z2labs/coaxolotl/simu/out/bank_generic.png

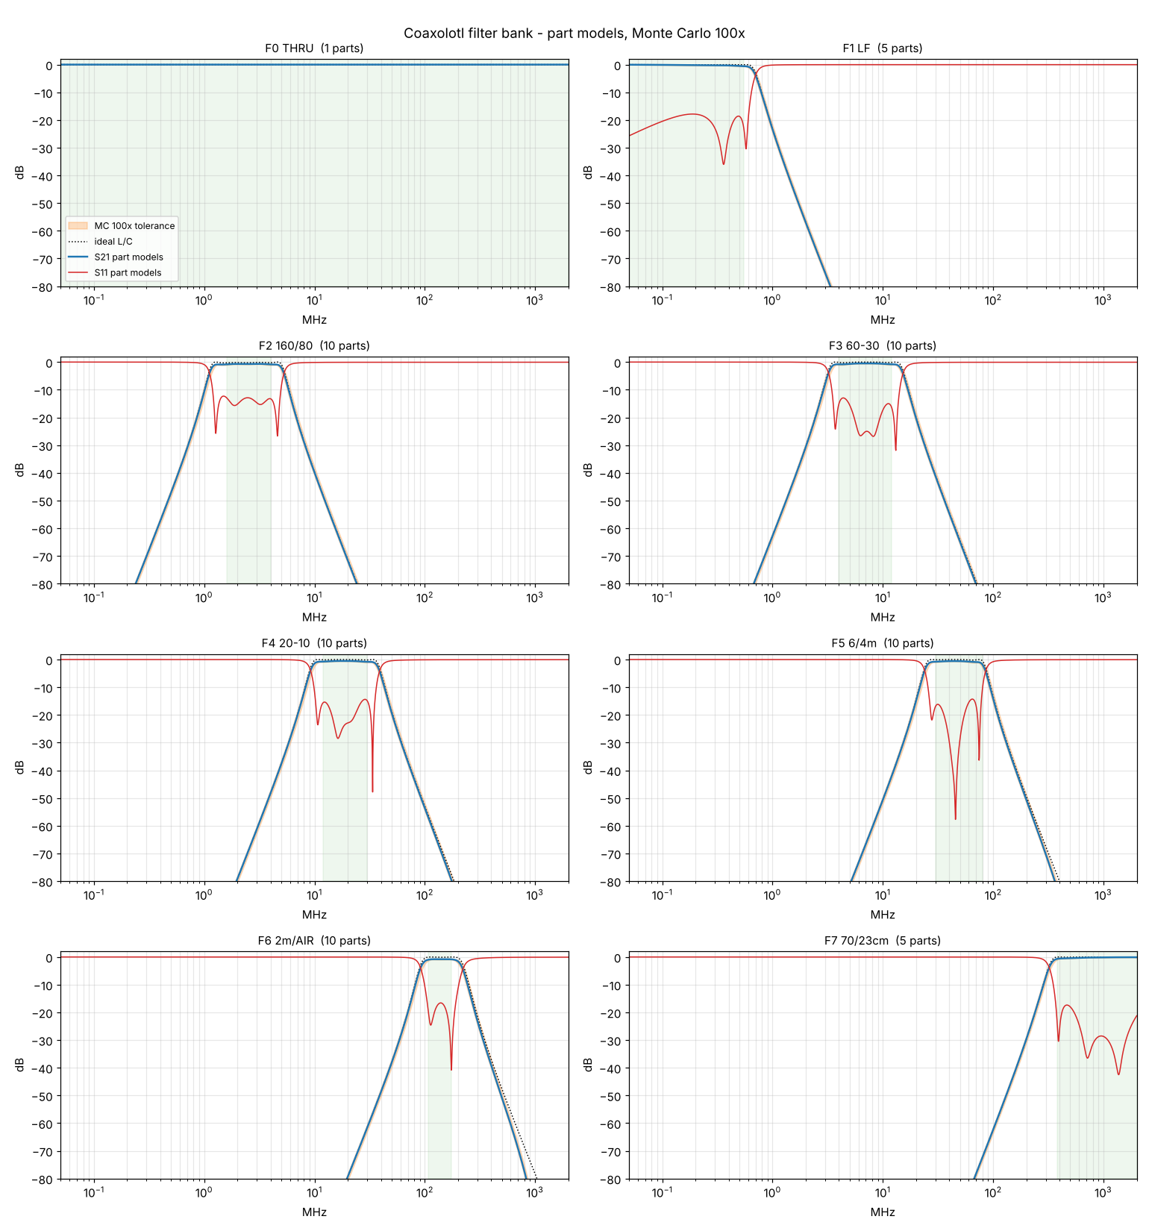
simu/out/bank_generic.png
