z2labs/coaxolotl/simu/out/bank_ideal.png

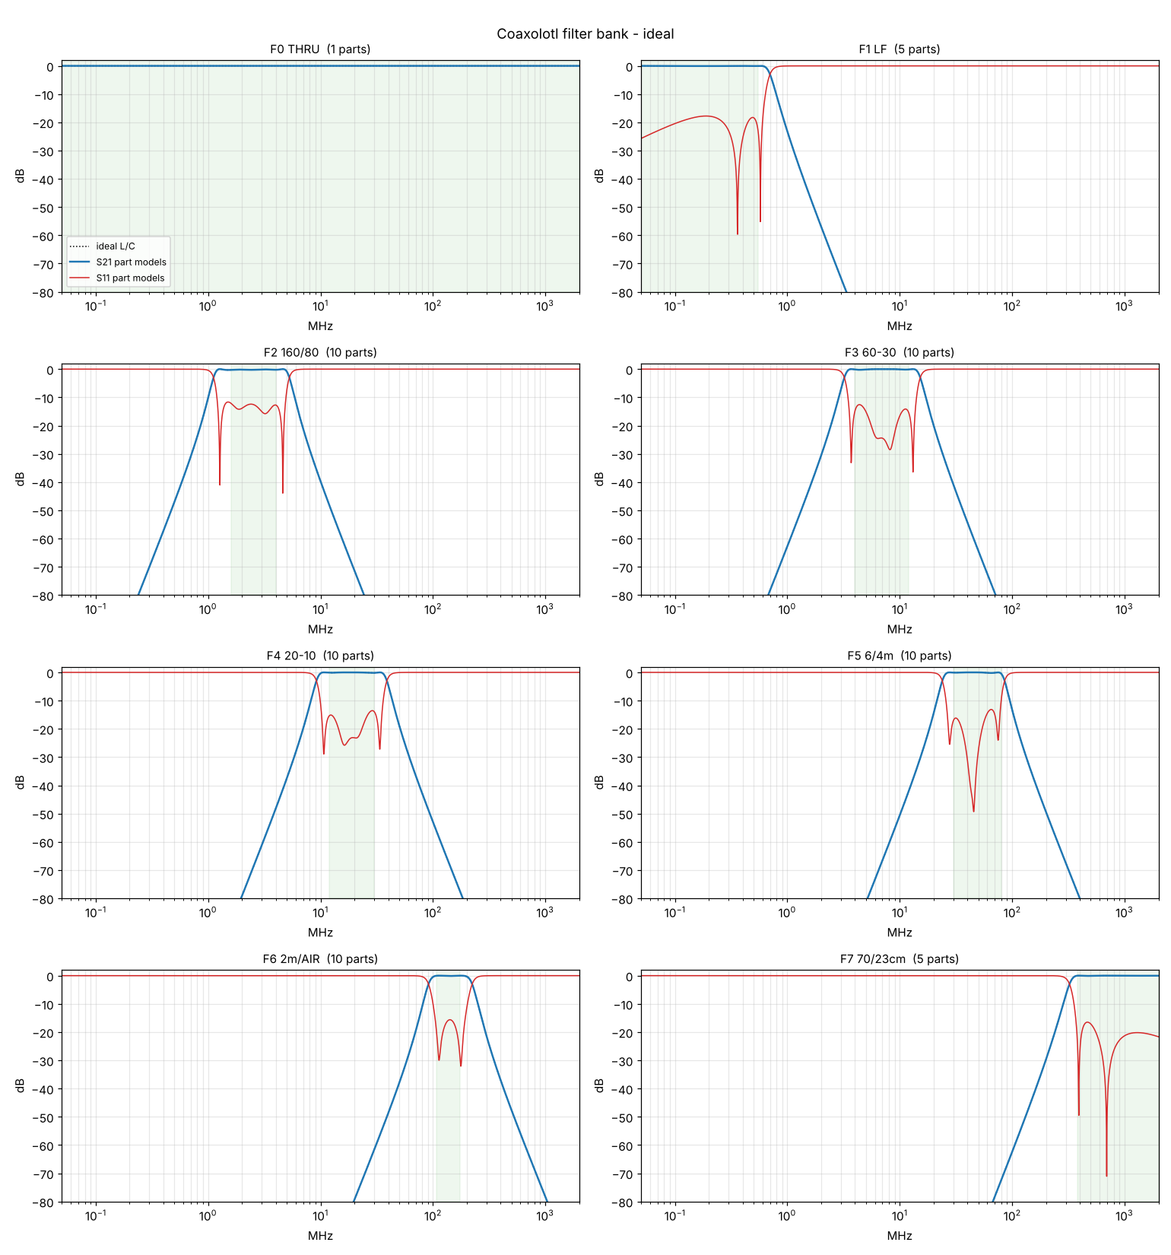
simu/out/bank_ideal.png
