z2labs/coaxolotl/simu/out/bank_models.png

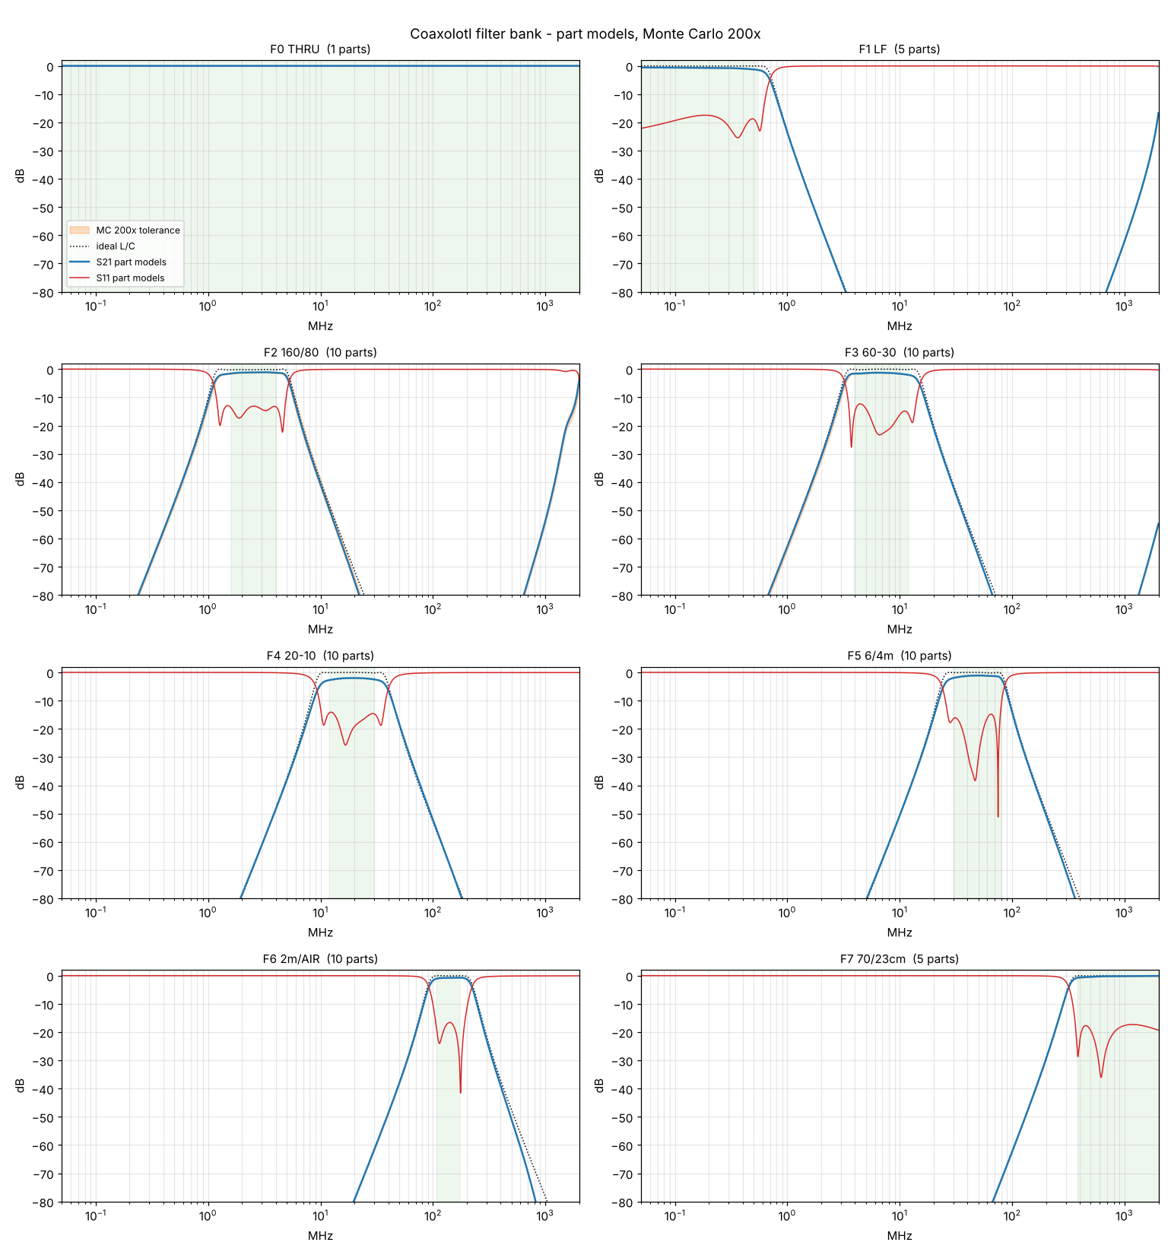
simu/out/bank_models.png
