z2labs/coaxolotl/simu/out/f0_layout.png

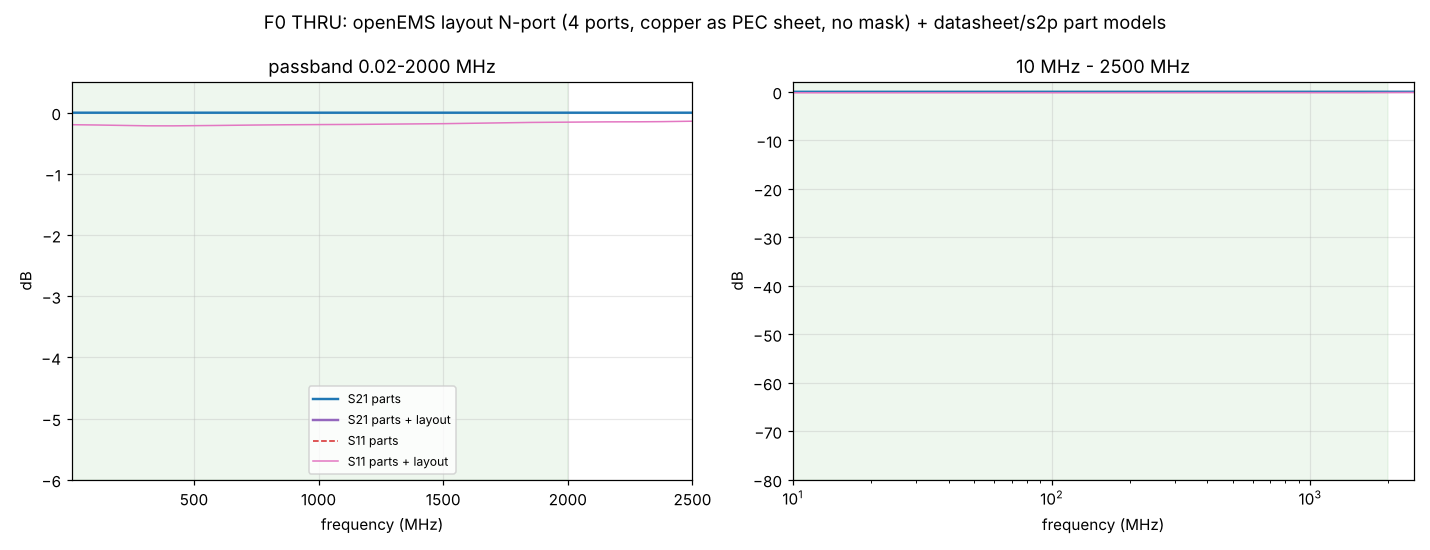
simu/out/f0_layout.png
