z2labs/coaxolotl/simu/out/f5_layout.png

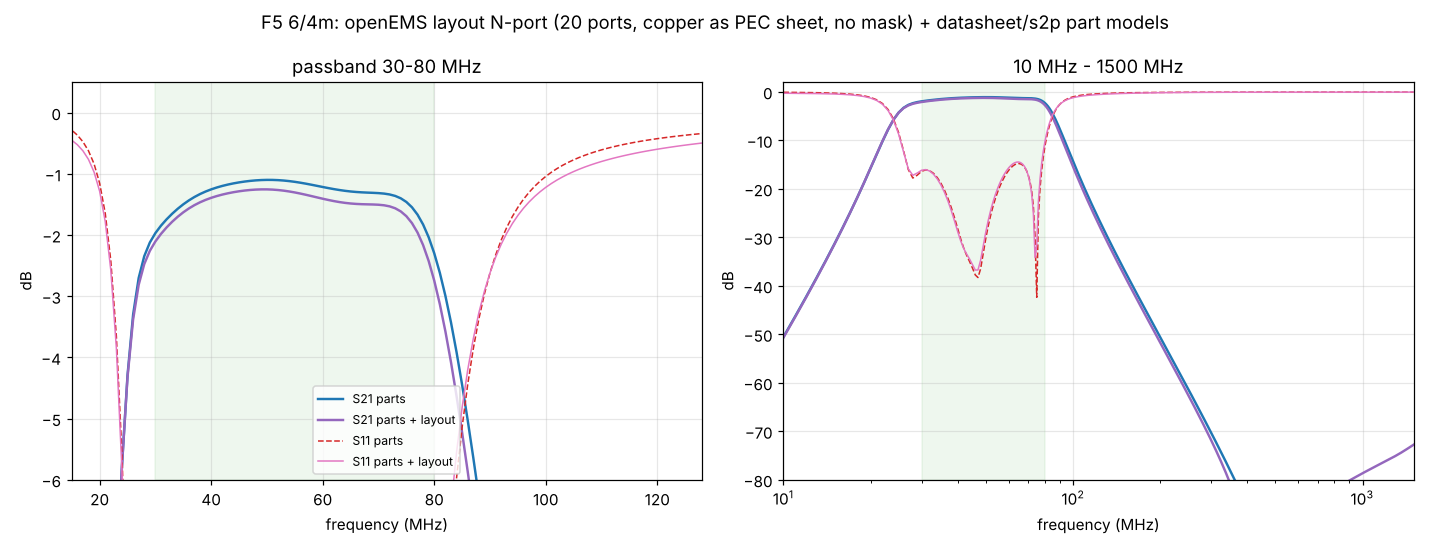
simu/out/f5_layout.png
