z2labs/coaxolotl/simu/out/f6_layout.png

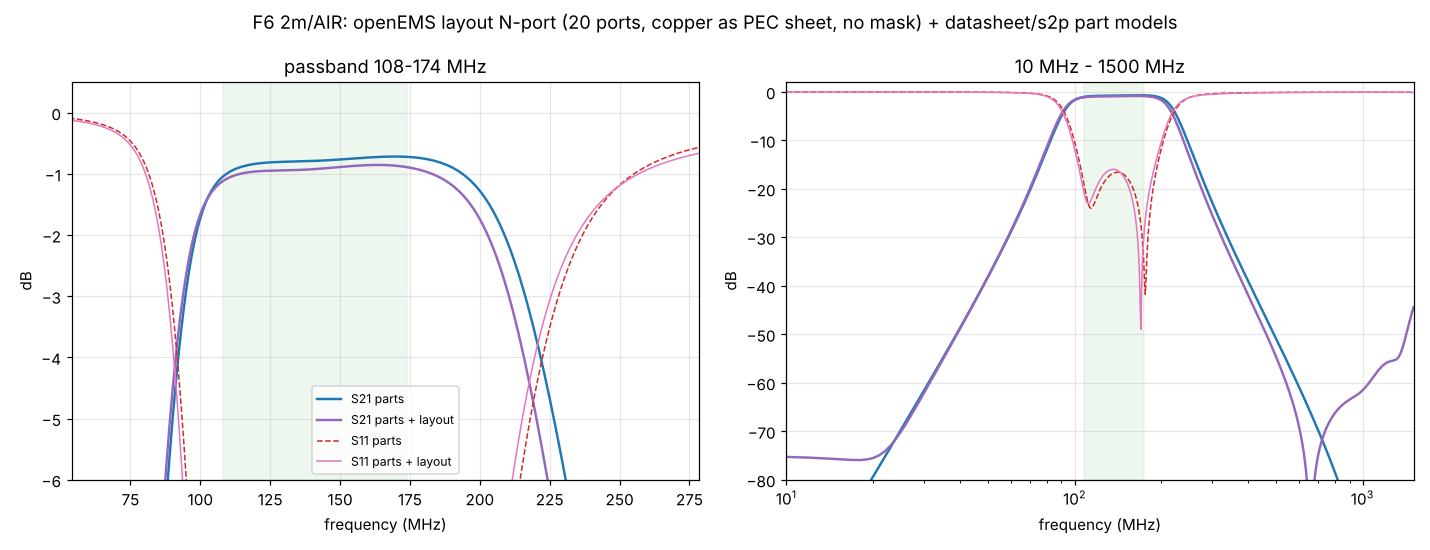
simu/out/f6_layout.png
