z2labs/coaxolotl/simu/out/f7_layout.png

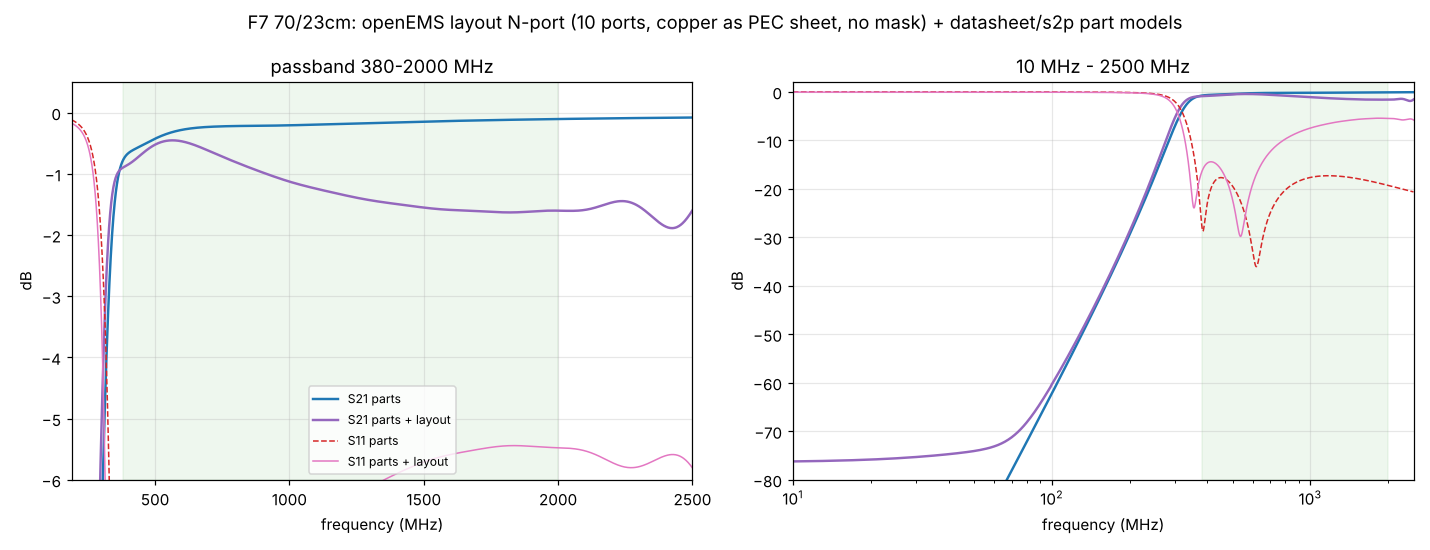
simu/out/f7_layout.png
