z2labs/coaxolotl/simu/out/f7_retune.png

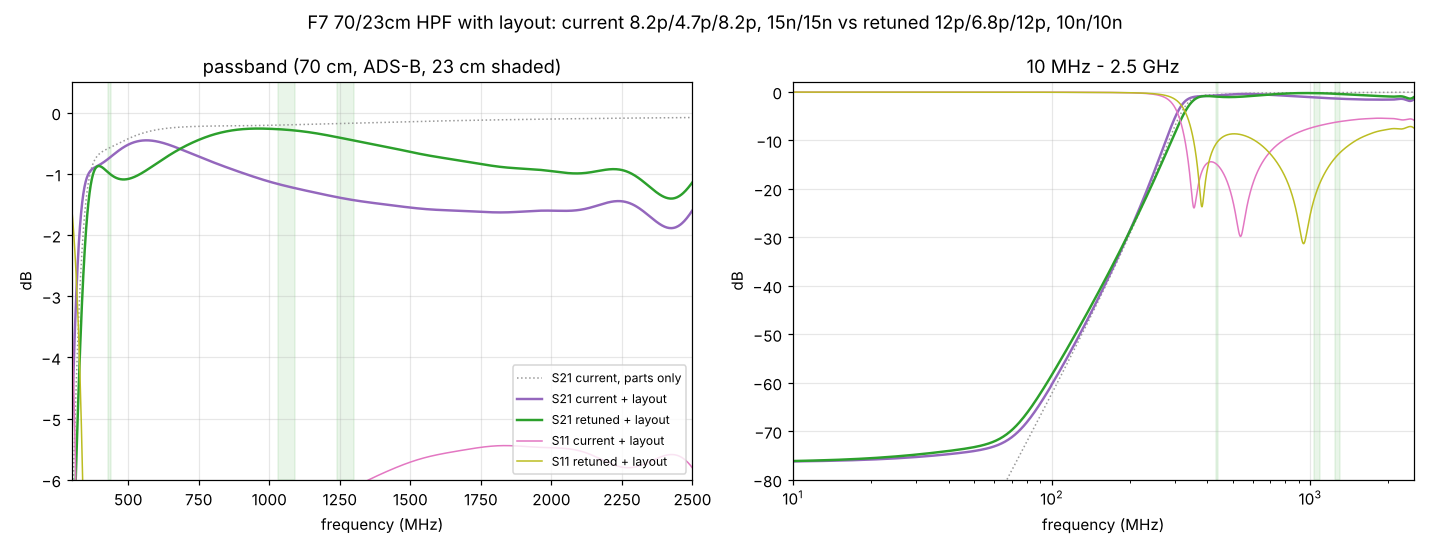
simu/out/f7_retune.png
