z2labs/coaxolotl/simu/out/f7void_layout.png

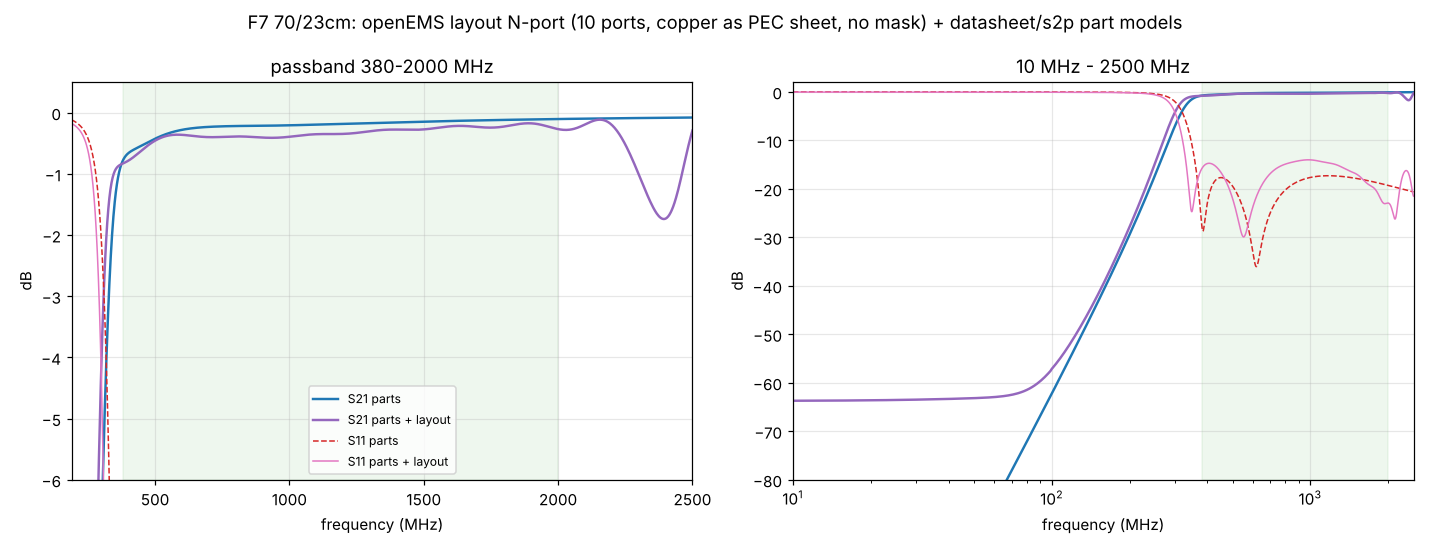
simu/out/f7void_layout.png
