z2labs/coaxolotl/simu/out/report_fig/bank.png

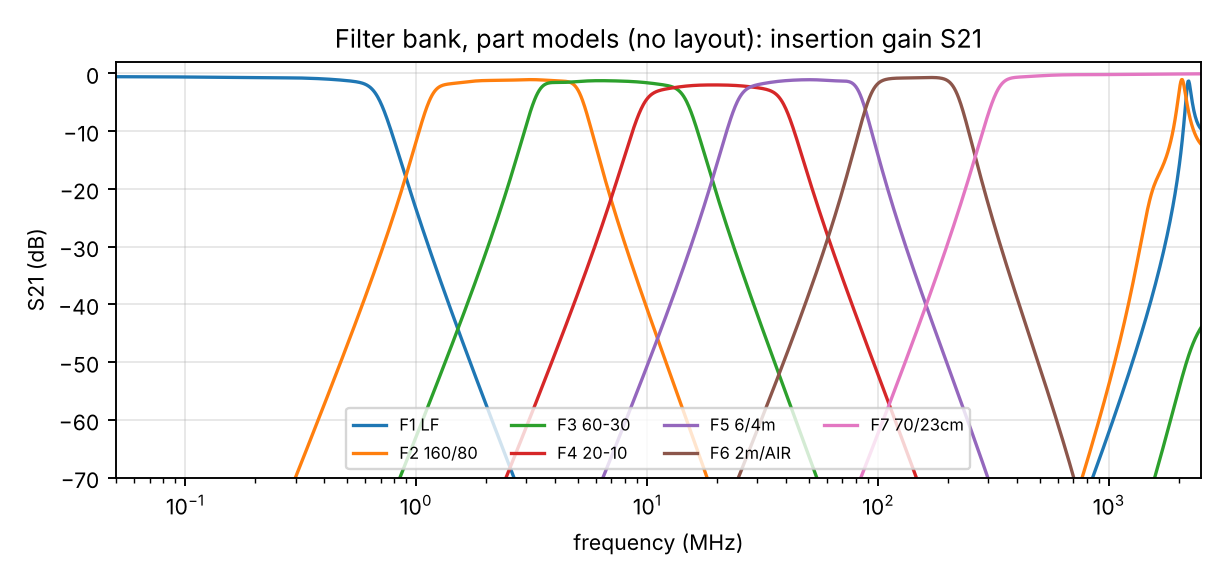
simu/out/report_fig/bank.png
