z2labs/coaxolotl/simu/out/report_fig/f7.png

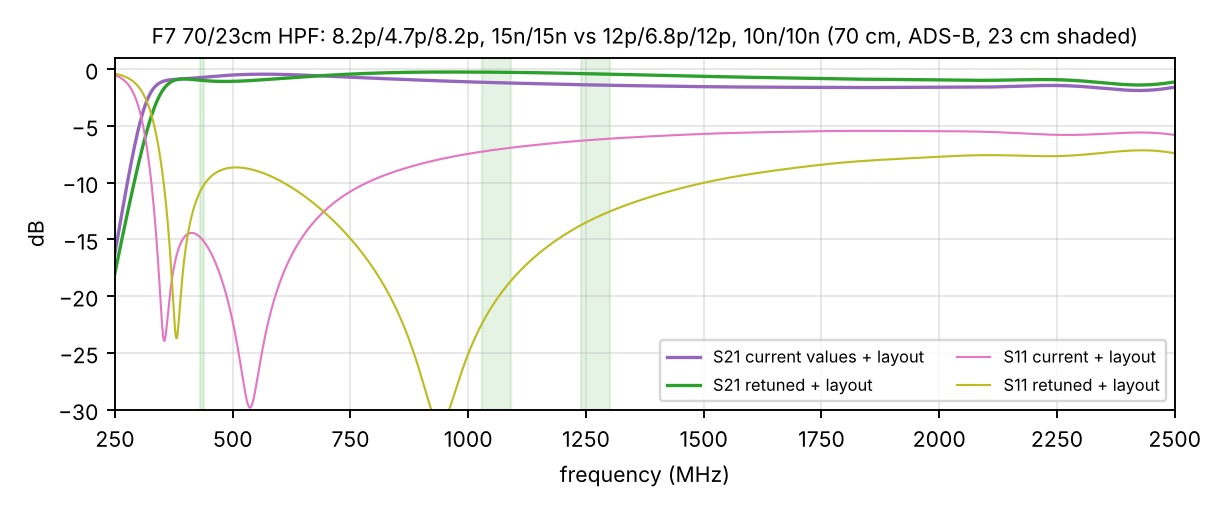
simu/out/report_fig/f7.png
