z2labs/coaxolotl/simu/out/report_fig/lanes.png

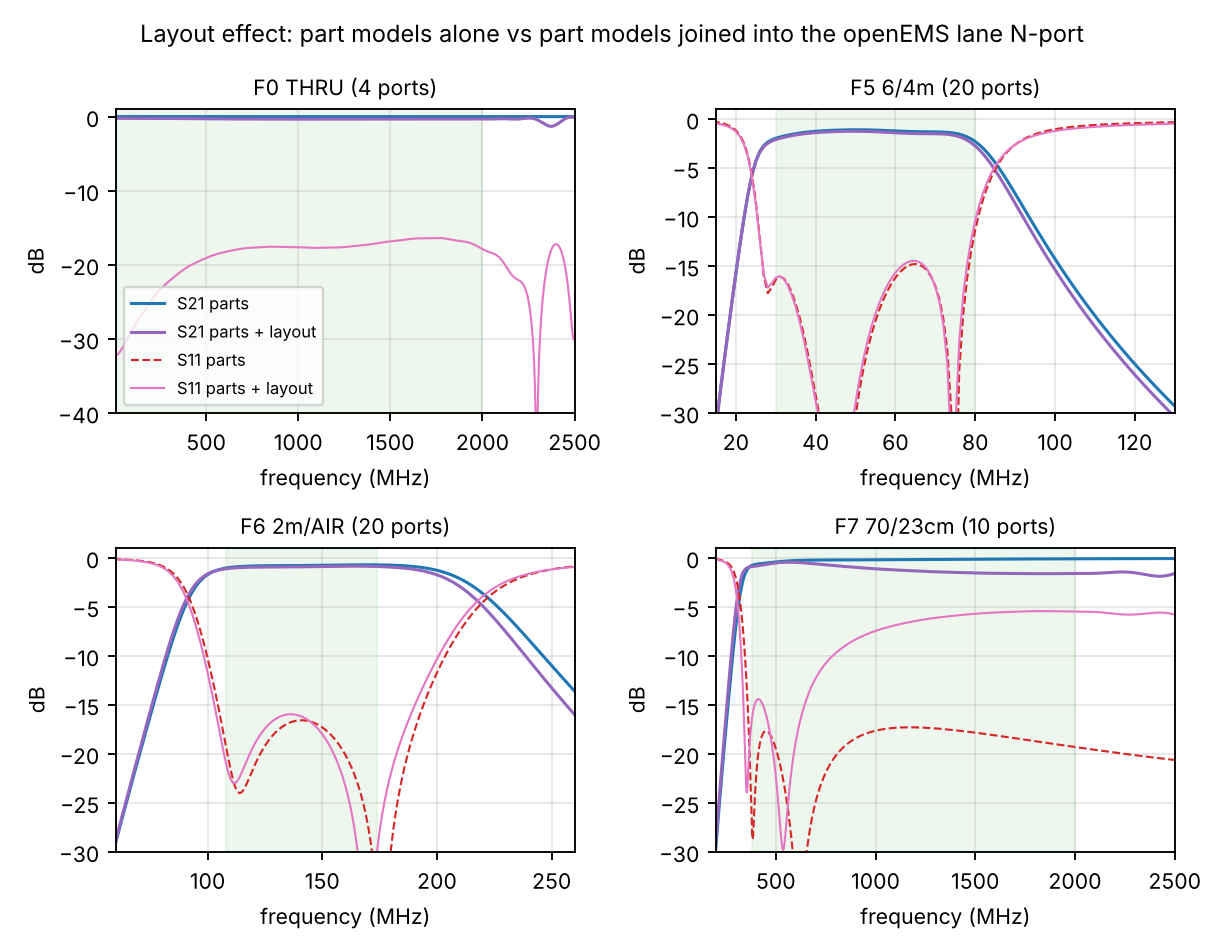
simu/out/report_fig/lanes.png
