z2labs/coaxolotl/simu/out/thru_layout.png

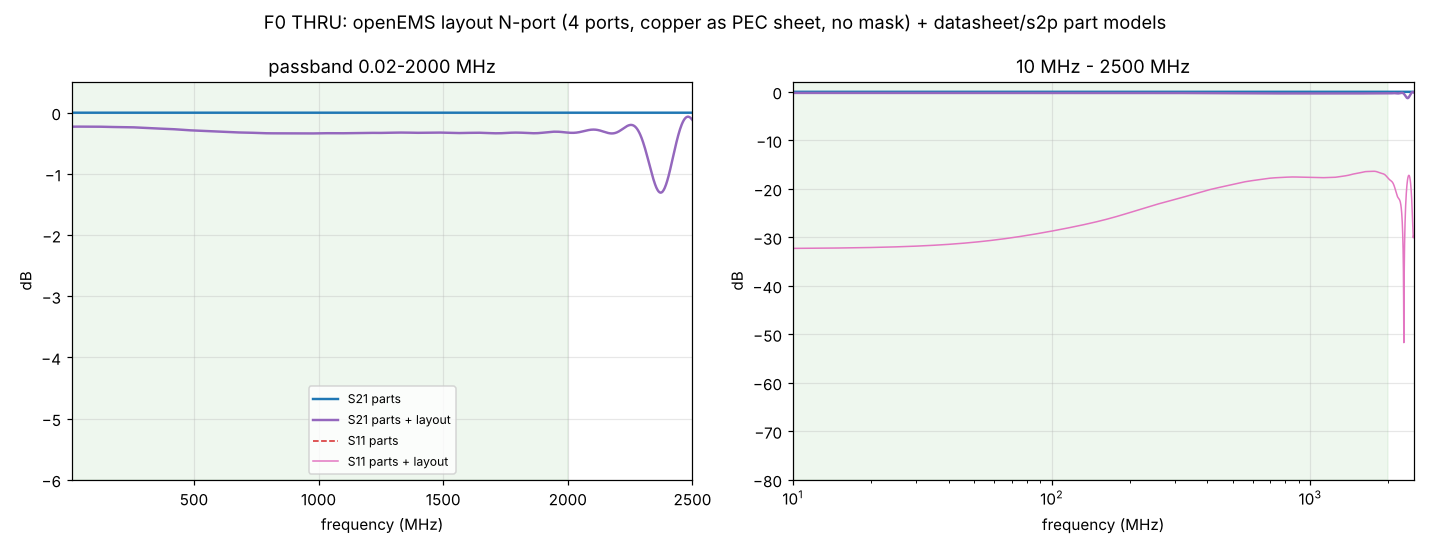
simu/out/thru_layout.png
