z2labs/coaxolotl/hardware/bom.csv

refs | qty | value | footprint | mpn | dnp | sheet | note
C1 C6 C7 C11 C15 C36 C37 C38 C39 C41 C42 C43 C44 C45 C46 | 15 | 100nF/16V/10% | C_0603_1608Metric |  |  | Filter bank, MCU, Panel, Power, RF front end
C2 | 1 | 10nF/50V/10% | C_0603_1608Metric |  |  | MCU
C3 | 1 | 10uF/10V/20% | C_0805_2012Metric |  |  | Power
C4 C5 C12 C13 C14 | 5 | 1uF/16V/10% | C_0603_1608Metric |  |  | MCU, Power
C8 | 1 | 47uF/10V/20% | C_1206_3216Metric |  |  | Power
C9 | 1 | 330uF/6.3V/20% | CP_EIA-7343-31_Kemet-D | T520D337M006ATE025 |  | Power
C10 | 1 | 0.1F/5.5V | CP_Radial_D13.0mm_P5.00mm | KR-5R5V104-R |  | Power | C10: VERIFY footprint vs chosen coin supercap
C24 C26 | 2 | 200pF/50V/C0G | C_0603_1608Metric |  |  | RF front end
C25 | 1 | 68pF/50V/C0G | C_0603_1608Metric |  |  | RF front end
C27 | 1 | NA(47pF/C0G) | C_0603_1608Metric |  | DNP | RF front end
C28 C31 C34 | 3 | 1nF/50V/C0G | C_0603_1608Metric |  |  | Filter bank, RF front end
C30 C32 C40 | 3 | 100pF/C0G | C_0603_1608Metric |  |  | RF front end
C33 | 1 | 2.2uF/16V/X7R | C_0805_2012Metric |  |  | Filter bank
C35 | 1 | 22pF/50V/C0G | C_0603_1608Metric |  |  | Filter bank
C101 C103 | 2 | 5.6nF/50V/C0G | C_0603_1608Metric |  |  | Filter bank
C102 | 1 | 10nF/50V/C0G | C_0603_1608Metric |  |  | Filter bank
C201 C203 | 2 | 2.2nF/50V/C0G | C_0603_1608Metric |  |  | Filter bank
C202 | 1 | 1.2nF/50V/C0G | C_0603_1608Metric |  |  | Filter bank
C204 C206 C301 C303 | 4 | 820pF/50V/C0G | C_0603_1608Metric |  |  | Filter bank
C205 | 1 | 1.5nF/50V/C0G | C_0603_1608Metric |  |  | Filter bank
C302 C305 | 2 | 470pF/50V/C0G | C_0603_1608Metric |  |  | Filter bank
C304 C306 C401 C403 | 4 | 270pF/50V/C0G | C_0603_1608Metric |  |  | Filter bank
C402 | 1 | 150pF/50V/C0G | C_0603_1608Metric |  |  | Filter bank
C404 C406 C501 C503 | 4 | 100pF/50V/C0G | C_0603_1608Metric |  |  | Filter bank
C405 | 1 | 180pF/50V/C0G | C_0603_1608Metric |  |  | Filter bank
C502 | 1 | 56pF/50V/C0G | C_0603_1608Metric |  |  | Filter bank
C504 C506 | 2 | 47pF/50V/C0G | C_0603_1608Metric |  |  | Filter bank
C505 | 1 | 82pF/50V/C0G | C_0603_1608Metric |  |  | Filter bank
C601 C603 | 2 | 27pF/50V/C0G | C_0603_1608Metric |  |  | Filter bank
C602 | 1 | 15pF/50V/C0G | C_0603_1608Metric |  |  | Filter bank
C604 C606 | 2 | 18pF/50V/C0G | C_0603_1608Metric |  |  | Filter bank
C605 | 1 | 33pF/50V/C0G | C_0603_1608Metric |  |  | Filter bank
C701 C703 | 2 | 8.2pF/50V/C0G | C_0603_1608Metric |  |  | Filter bank
C702 | 1 | 4.7pF/50V/C0G | C_0603_1608Metric |  |  | Filter bank
D1 | 1 | SMF5.0A(SOD123F) | D_SOD-123F |  |  | Power
D2 | 1 | LED/GREEN(0603) | LED_0603_1608Metric |  |  | Power | D2: PWR lamp, works without MCU
D3 D4 D5 | 3 | BAT54WS(SOD323) | D_SOD-323 |  |  | Power
D6 | 1 | BAV99W(SOT323) | SOT-323_SC-70 |  |  | RF front end | D6: clamp +-0.7 V, ~1.5 pF
D7 D8 D9 D10 D11 D12 D13 D14 D15 D16 D17 D18 D19 D20 D21 D22 D23 D24 D25 D26 D27 D28 D29 D30 D43 | 25 | AMBER(0603) | LED_0603_1608Metric |  |  | Panel
D31 D32 D41 D42 D44 D51 D53 | 7 | YELLOW(0603) | LED_0603_1608Metric |  |  | Panel
D33 D40 D45 D48 D49 | 5 | GREEN(0603) | LED_0603_1608Metric |  |  | Panel
D34 D35 D36 D37 D38 D39 D46 D47 D50 D52 D54 | 11 | RED(0603) | LED_0603_1608Metric |  |  | Panel
FB1 FB2 | 2 | FB0603/600R/1.3A | L_0603_1608Metric | BLM18KG601SN1D |  | Power, RF front end
GDT1 | 1 | 4532-090V(1812) | GDT_SMD_1812 | 4532-090V |  | RF front end | GDT1: 90 V, 0.5 pF
J1 | 1 | C2_DEBUG | PinHeader_1x04_P2.54mm_Vertical |  |  | MCU
J2 | 1 | SMA/EDGE(ANT) | SMA_Amphenol_132289_EdgeMount |  |  | RF front end
J3 | 1 | SMA/EDGE(RTL-SDR) | SMA_Amphenol_132289_EdgeMount |  |  | Filter bank
J4 J5 | 2 | NA(HDR1x7/2.54) | PinHeader_1x07_P2.54mm_Vertical |  | DNP | Panel
L1 L2 L501 L502 | 4 | 220nH/5% | L_0603_1608Metric |  |  | Filter bank, RF front end
L3 | 1 | NA(56nH/2%) | L_0603_1608Metric |  | DNP | RF front end
L4 | 1 | 560nH/5% | L_0603_1608Metric |  |  | RF front end | L4: low-band choke (SWL434)
L5 | 1 | 100nH/0603 | L_0603_1608Metric |  |  | Filter bank
L6 | 1 | 10uH/0.45A(1210) | L_1210_3225Metric | LQH32CN100K33L |  | Filter bank
L7 | 1 | 1mH/0.2A | L_Bourns_SRR1260 | SRR1260-102M |  | Filter bank
L8 | 1 | 18nH/2% | L_0603_1608Metric |  |  | RF front end | L8: high-band choke at the pin (QPL9547 EVB L1)
L101 L102 | 2 | 18uH/5% | L_1210_3225Metric |  |  | Filter bank
L201 L202 | 2 | 4.7uH/5% | L_0805_2012Metric |  |  | Filter bank
L203 L204 | 2 | 2.2uH/5% | L_0805_2012Metric |  |  | Filter bank
L301 L302 | 2 | 1.5uH/5% | L_0805_2012Metric |  |  | Filter bank
L303 L304 | 2 | 820nH/5% | L_0805_2012Metric |  |  | Filter bank
L401 L402 | 2 | 560nH/5% | L_0805_2012Metric |  |  | Filter bank
L403 L404 | 2 | 330nH/5% | L_0603_1608Metric |  |  | Filter bank
L503 L504 | 2 | 150nH/5% | L_0603_1608Metric |  |  | Filter bank
L601 L602 L603 L604 | 4 | 56nH/5% | L_0603_1608Metric |  |  | Filter bank
L701 L702 | 2 | 15nH/5% | L_0603_1608Metric |  |  | Filter bank
R1 | 1 | 680R/1% | R_0603_1608Metric |  |  | Power | R1: sets the OOK falling edge
R2 | 1 | 3k3/5% | R_0603_1608Metric |  |  | Power
R3 | 1 | 10k/1% | R_0603_1608Metric |  |  | Power
R4 | 1 | 22k/1% | R_0603_1608Metric |  |  | Power
R5 | 1 | 150k/1% | R_0603_1608Metric |  |  | Power | R5: VERIFY vs TPS2553 Eq.1: IOS(min) > 130 mA
R6 R23 | 2 | 100k/5% | R_0603_1608Metric |  |  | MCU, RF front end | R23: static bleed (no choke: keeps 20 kHz)
R7 | 1 | 0R39/1%/0.25W | R_1206_3216Metric | ERJ-8BQFR39V |  | Power
R8 | 1 | 1k/1% | R_0603_1608Metric |  |  | MCU
R9 | 1 | 100R/5% | R_0603_1608Metric |  |  | Power
R10 R24 | 2 | 220R/5% | R_0603_1608Metric |  |  | Filter bank, Power | R24: damps the L6 self-resonance
R11 R12 | 2 | 1M/1% | R_0603_1608Metric |  |  | Power
R13 R14 R15 R16 R17 R18 R19 R20 R26 | 9 | 10k/5% | R_0603_1608Metric |  |  | Filter bank, MCU, Panel, Power, RF front end | R14: LNA off while MCU in reset; R15: bypass while MCU in reset; R16: F0 THRU while MCU in reset; R17: F0 THRU while MCU in reset; R18: F0 THRU while MCU in reset; R19: notch out while MCU in reset; R20: lamps dark until first write; R26: bypass while MCU in reset
R21 R22 | 2 | 0R/0603 | R_0603_1608Metric |  |  | Filter bank, RF front end | R21: F0 = straight through; R22: fit when the notch is not fitted
R25 | 1 | 3k32/1% | R_0603_1608Metric |  |  | RF front end | R25: sets IDD = 65 mA (QPL9547 EVB R4)
RN1 RN2 RN3 RN4 RN5 RN6 RN7 RN8 RN9 RN10 RN11 RN12 | 12 | 2k2x4/5%(CAY16) | R_Array_Convex_4x0603 | CAY16-222J4LF |  | Panel
TP1 | 1 | TP/TX | TestPoint_Pad_D1.0mm |  |  | MCU
TP6 | 1 | TP/SENSE | TestPoint_Pad_D1.0mm |  |  | MCU
U1 | 1 | LM66100DCKR(SC70-6) | SOT-363_SC-70-6 |  |  | Power
U2 | 1 | TPS2553DBVR(SOT23-6) | SOT-23-6 |  |  | Power
U3 | 1 | INA180A2IDBVR(SOT23-5) | SOT-23-5 |  |  | Power
U4 | 1 | MCP1700T-3302E/TT(SOT23) | SOT-23 |  |  | Power
U5 | 1 | EFM8BB21F16G-C(QSOP24) | QSOP-24_3.9x8.7mm_P0.635mm |  |  | MCU
U6 U7 | 2 | PE42520C-Z(QFN16) | QFN-16-1EP_3x3mm_P0.5mm_EP1.7x1.7mm |  |  | RF front end
U8 U11 | 2 | PE42582A(QFN24) | QFN-24-1EP_4x4mm_P0.5mm_EP2.6x2.6mm |  |  | Filter bank
U9 U10 | 2 | NA(PE42520C-Z) | QFN-16-1EP_3x3mm_P0.5mm_EP1.7x1.7mm |  | DNP | RF front end
U12 | 1 | LFCN-2250+(FV1206) | MiniCircuits_FV1206 |  |  | RF front end
U13 | 1 | QPL9547TR7(DFN8-2x2) | DFN-8-1EP_2x2mm_P0.5mm_EP0.8x1.6mm |  |  | RF front end | U13: EP: 0.25 mm vias under the paddle (datasheet p.8)
U14 U15 U16 U17 U18 U19 | 6 | 74HC595PW(TSSOP16) | TSSOP-16_4.4x5mm_P0.65mm |  |  | Panel
