z2labs/coaxolotl/hardware/kicad/coaxolotl-schematic.pdf

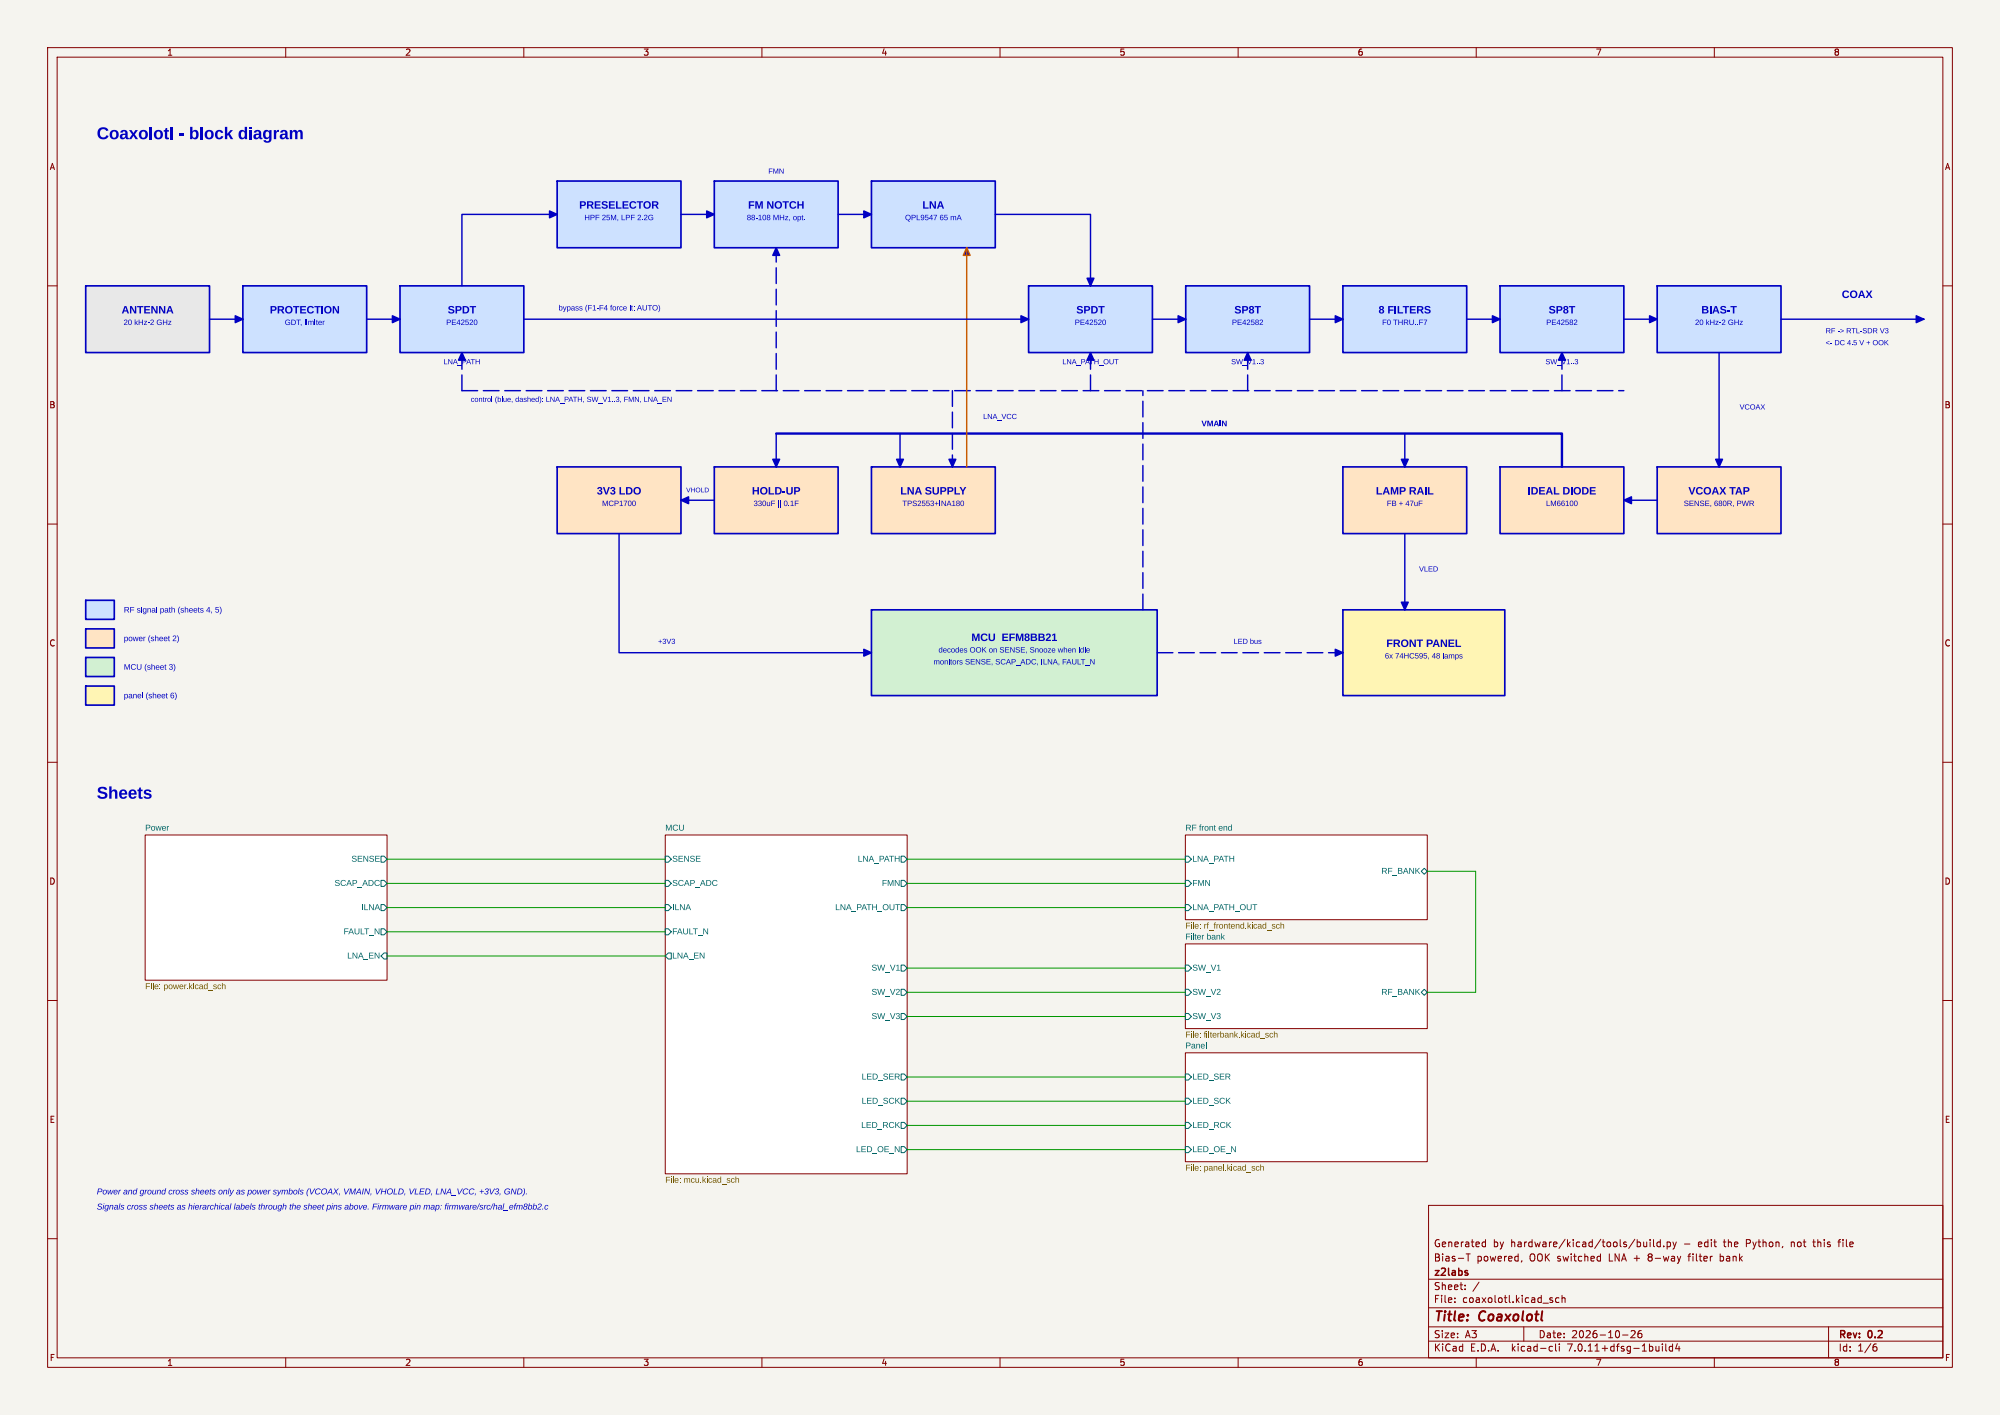
[picture p17: page 1]

88-108 MHz, opt. Coaxolotl - block diagram

Filter bank File: filterbank.kicad_sch

Power and ground cross sheets only as power symbols (VCOAX, VMAIN, VHOLD, VLED, LNA_VCC, +3V3, GND).
Signals cross sheets as hierarchical labels through the sheet pins above. Firmware pin map: firmware/src/hal_efm8bb2.c

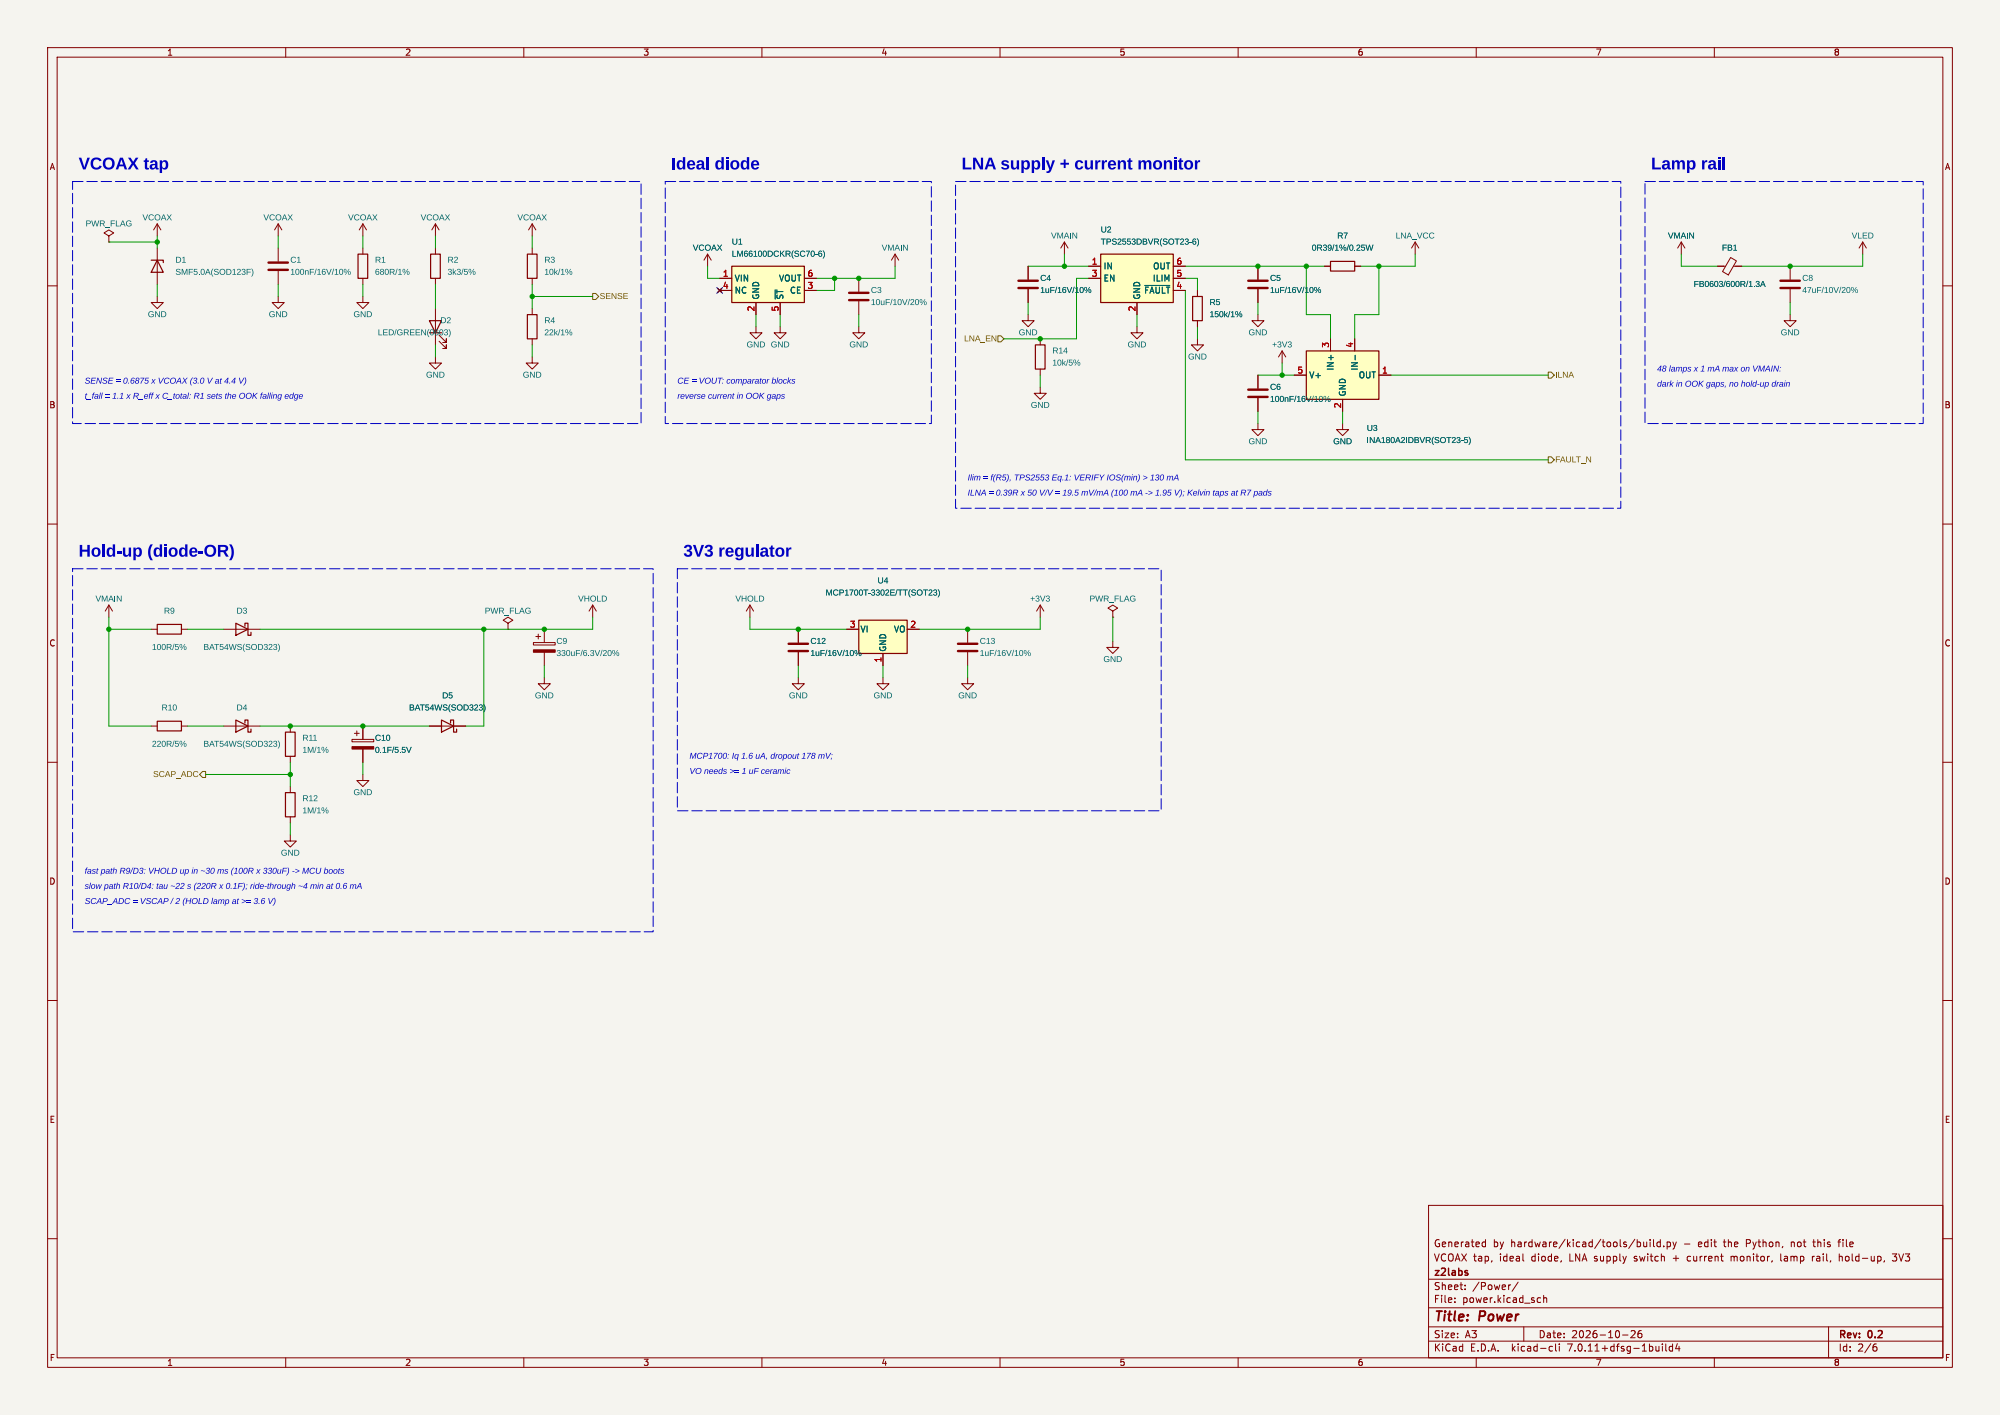
[picture p18: page 2]

LNA supply + current monitor

VMAIN
48 lamps x 1 mA max on VMAIN: FB1 FB0603/600R/1.3A

2 CE 3 NC 4 ~{ST} 5 VOUT 6 U1
LED/GREEN(0603) GND

2 CE 3 NC 4 ~{ST} 5 VOUT 6 C10

SENSE = 0.6875 x VCOAX (3.0 V at 4.4 V)
t_fall = 1.1 x R_eff x C_total: R1 sets the OOK falling edge

dark in OOK gaps, no hold-up drain VO needs >= 1 uF ceramic MCP1700: Iq 1.6 uA, dropout 178 mV;

Ilim = f(R5), TPS2553 Eq.1: VERIFY IOS(min) > 130 mA 3V3 regulator

ILNA = 0.39R x 50 V/V = 19.5 mV/mA (100 mA -> 1.95 V); Kelvin taps at R7 pads

fast path R9/D3: VHOLD up in ~30 ms (100R x 330uF) -> MCU boots
slow path R10/D4: tau ~22 s (220R x 0.1F); ride-through ~4 min at 0.6 mA
SCAP_ADC = VSCAP / 2 (HOLD lamp at >= 3.6 V)

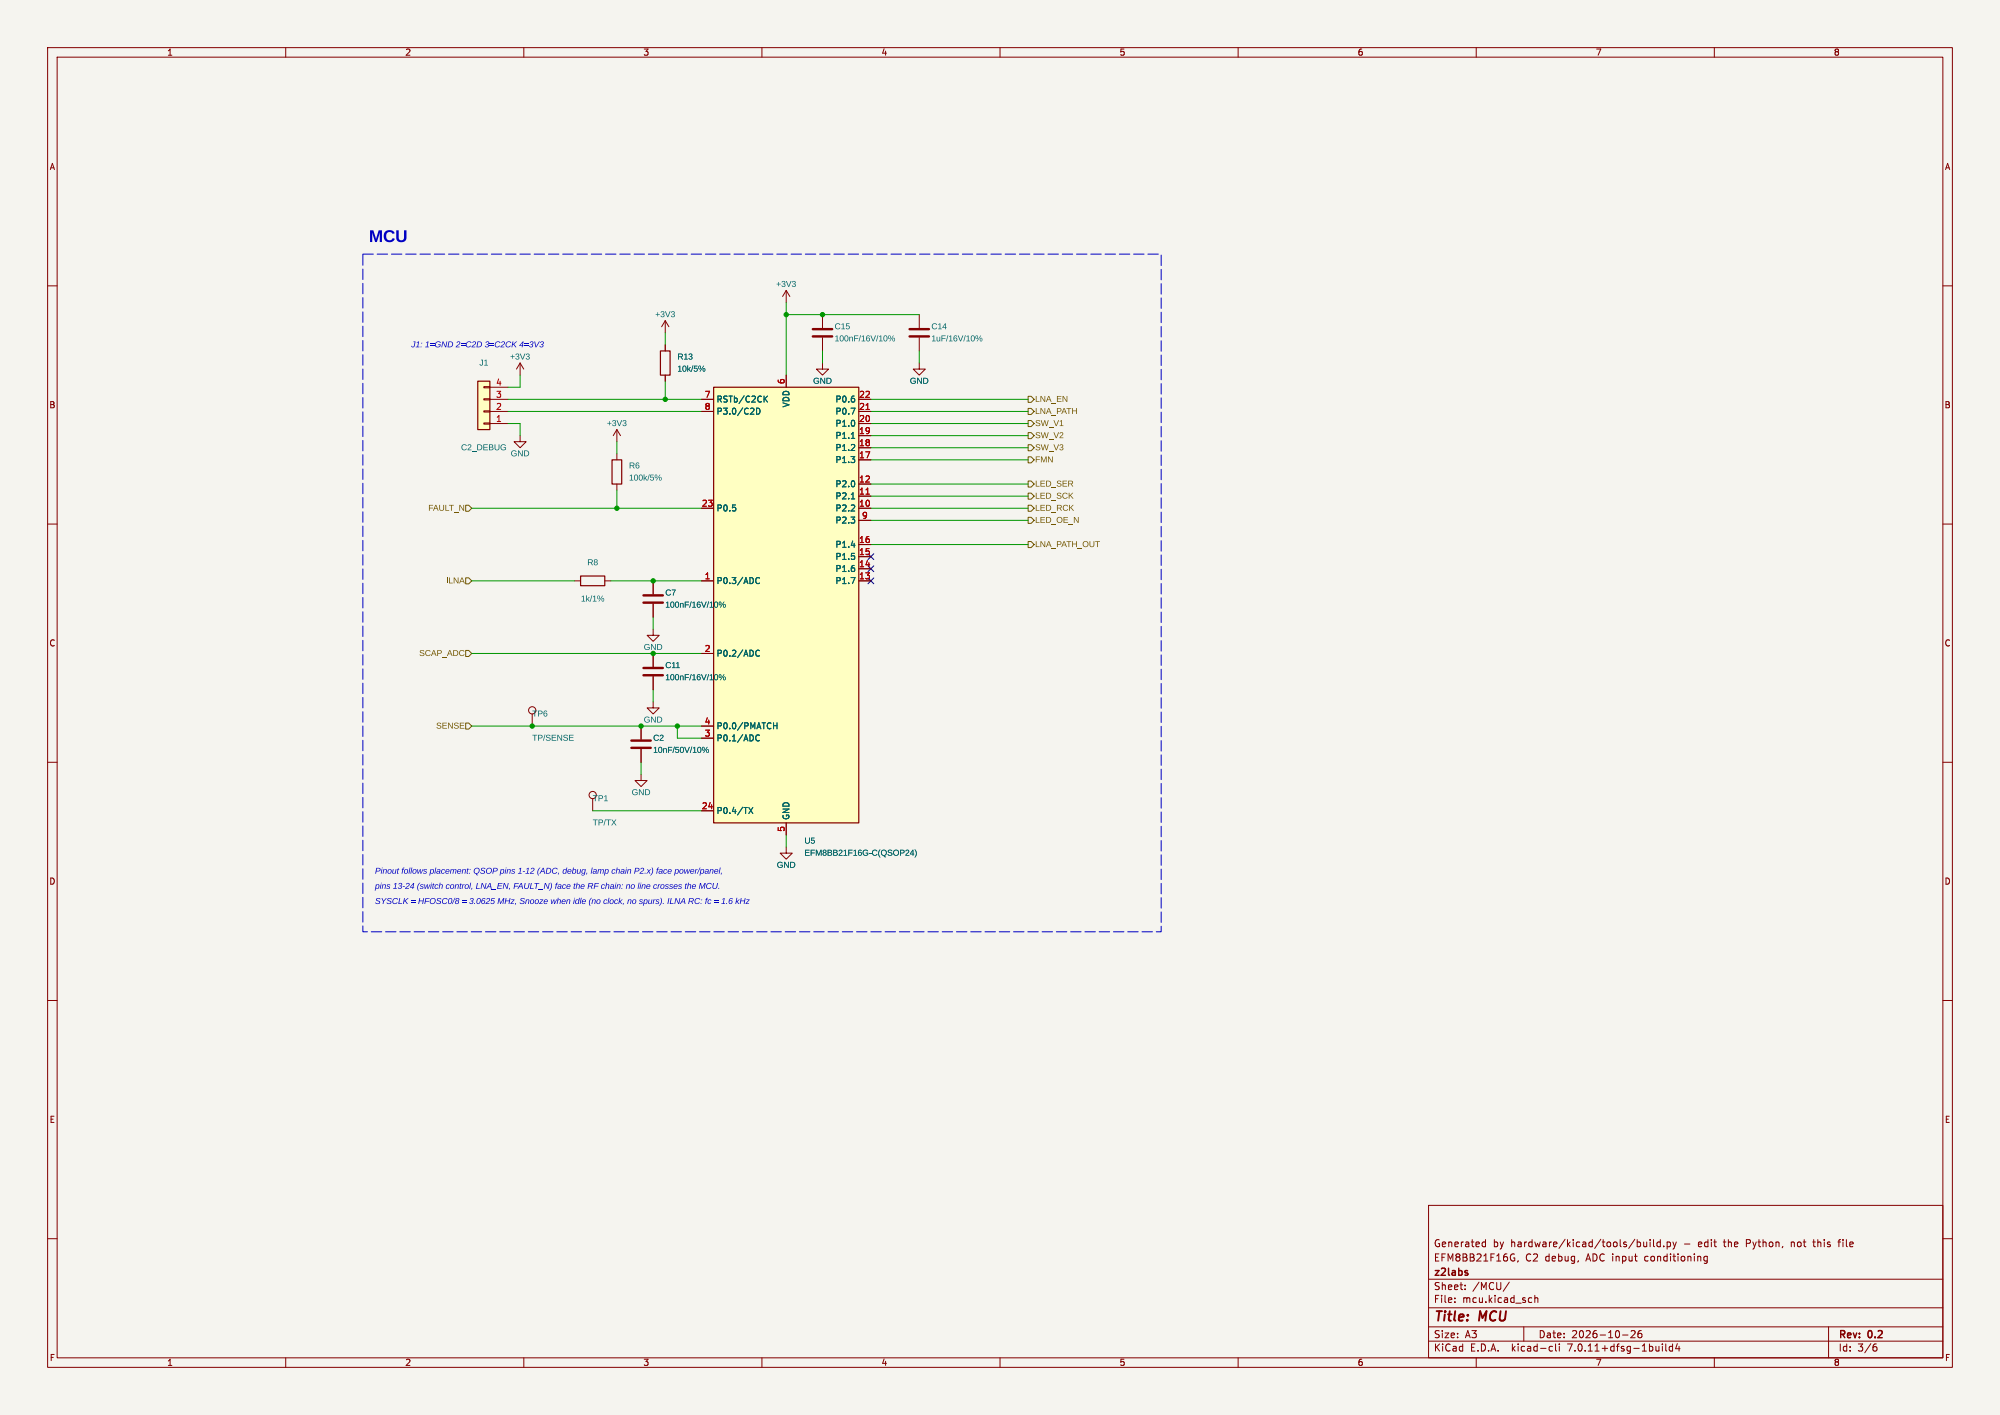
[picture p19: page 3]

Pinout follows placement: QSOP pins 1-12 (ADC, debug, lamp chain P2.x) face power/panel, SYSCLK = HFOSC0/8 = 3.0625 MHz, Snooze when idle (no clock, no spurs). ILNA RC: fc = 1.6 kHz pins 13-24 (switch control, LNA_EN, FAULT_N)face the RF chain: no line crosses the MCU.

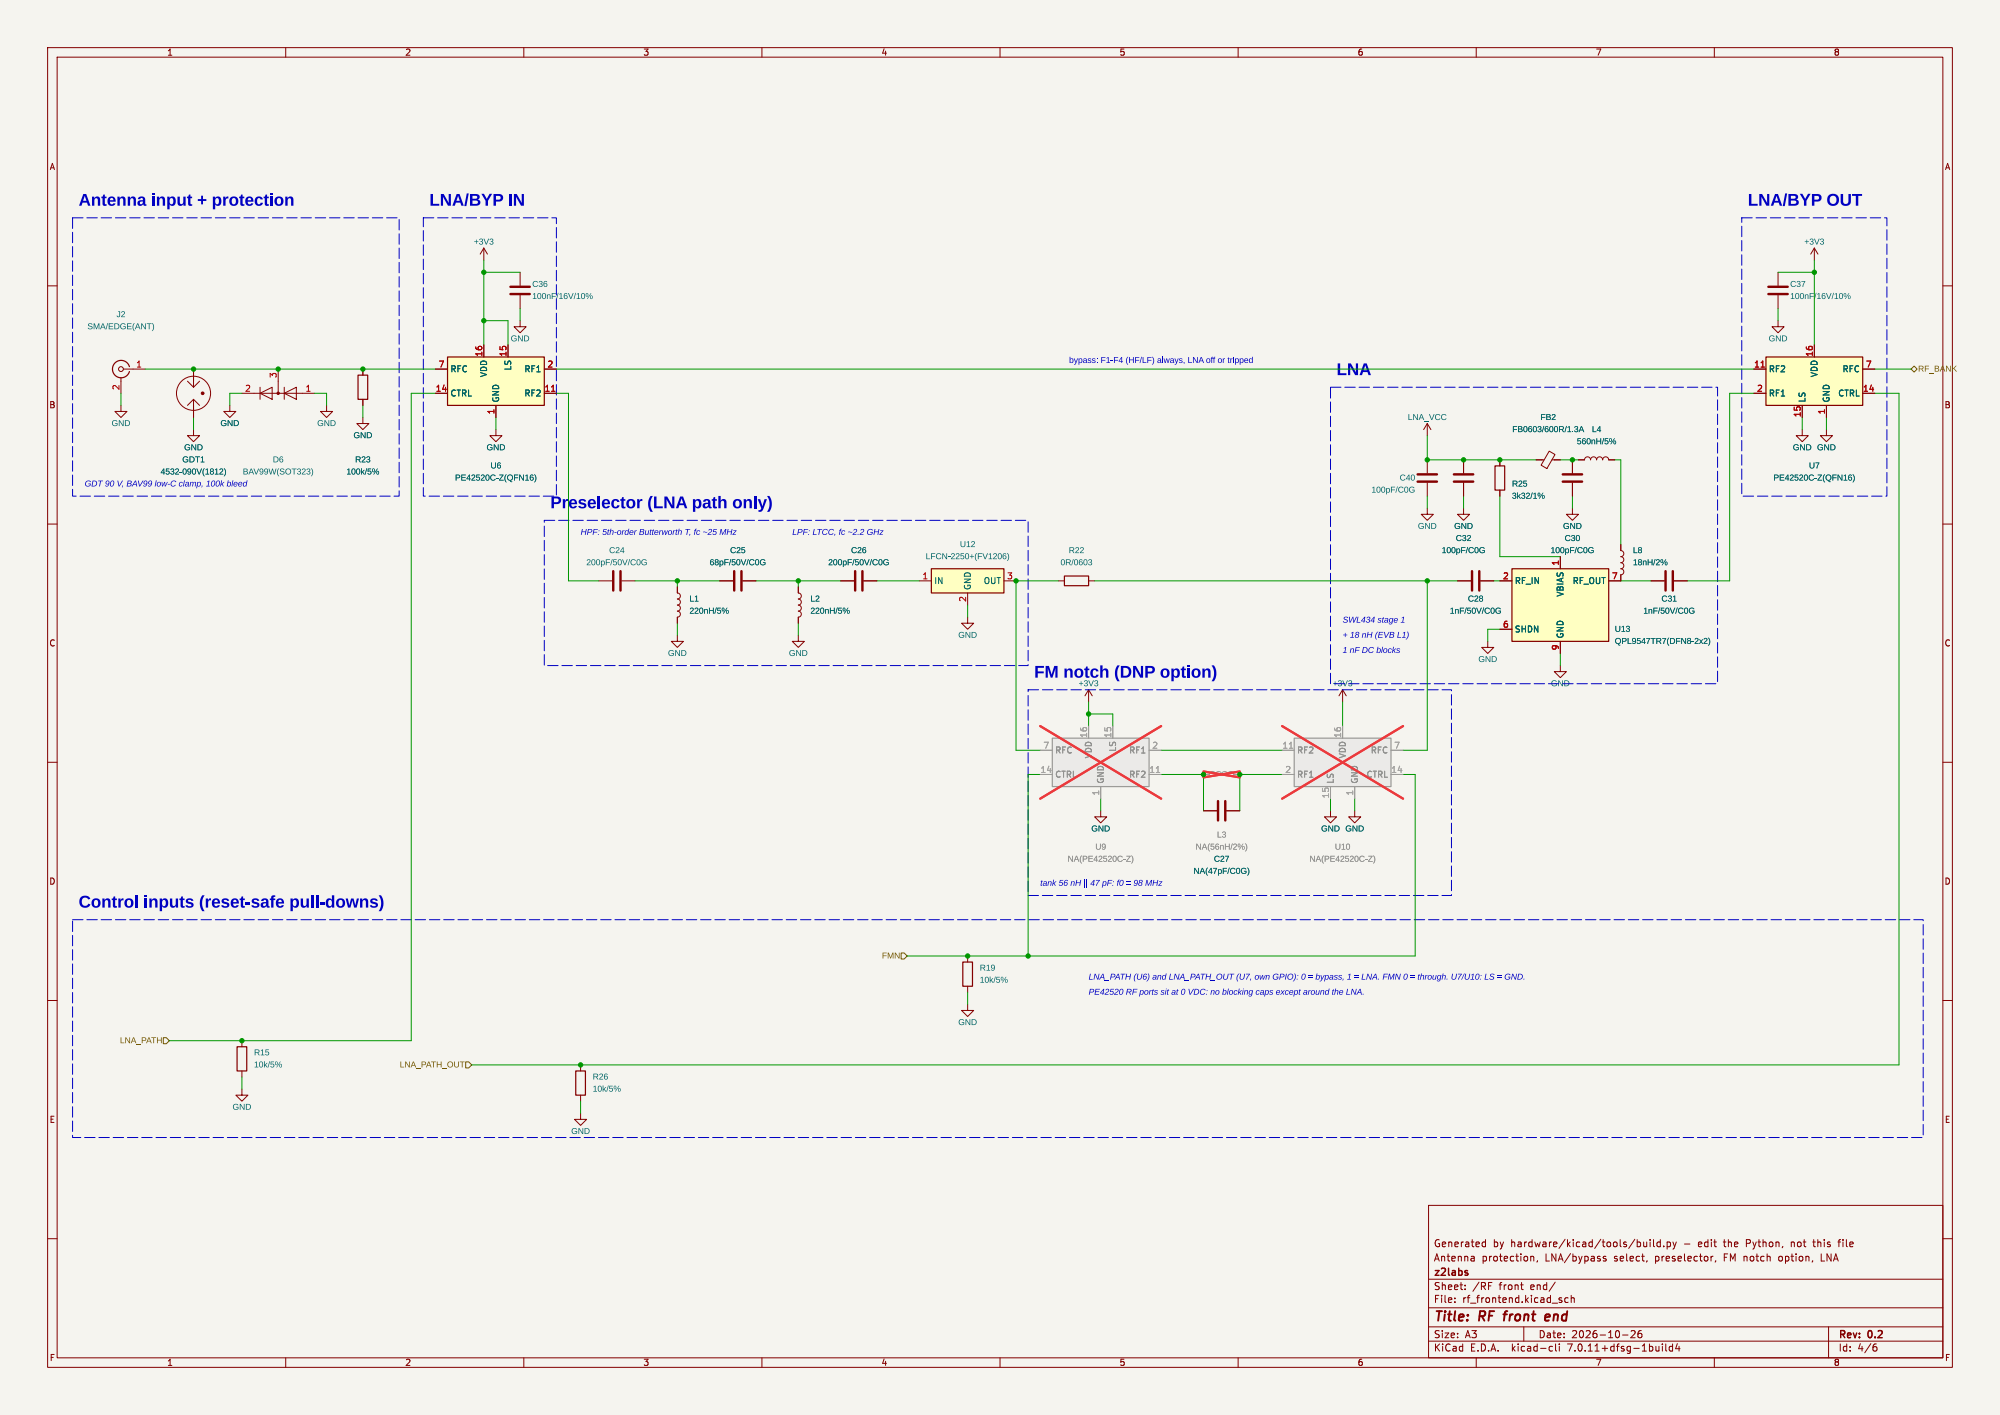
[picture p20: page 4]

1 RF2 11 CTRL 14 LS 15 VDD 16 RF1 2 RFC 7 U6 PE42520C-Z(QFN16) GND

1 RF2 11 CTRL 14 LS 15 VDD 16 RF1 2 RFC 7 C27 NA(47pF/C0G) L3 NA(56nH/2%) GND

bypass: F1-F4 (HF/LF) always, LNA off or tripped

1 RF2 11 CTRL 14 LS 15 VDD 16 RF1 2 RFC 7 U9 NA(PE42520C-Z) GND L3 NA(56nH/2%) C27 NA(47pF/C0G) +3V3 GND GND GND

FM notch (DNP option)

1 RF2 11 CTRL 14 LS 15 VDD 16 RF1 2 RFC 7 GND

1 RF2 11 CTRL 14 LS 15 VDD 16 RF1 2 RFC 7 U10 NA(PE42520C-Z) GND GND

Control inputs (reset-safe pull-downs)

tank 56 nH || 47 pF: f0 = 98 MHz

Id: 4/6 Title: RF front end

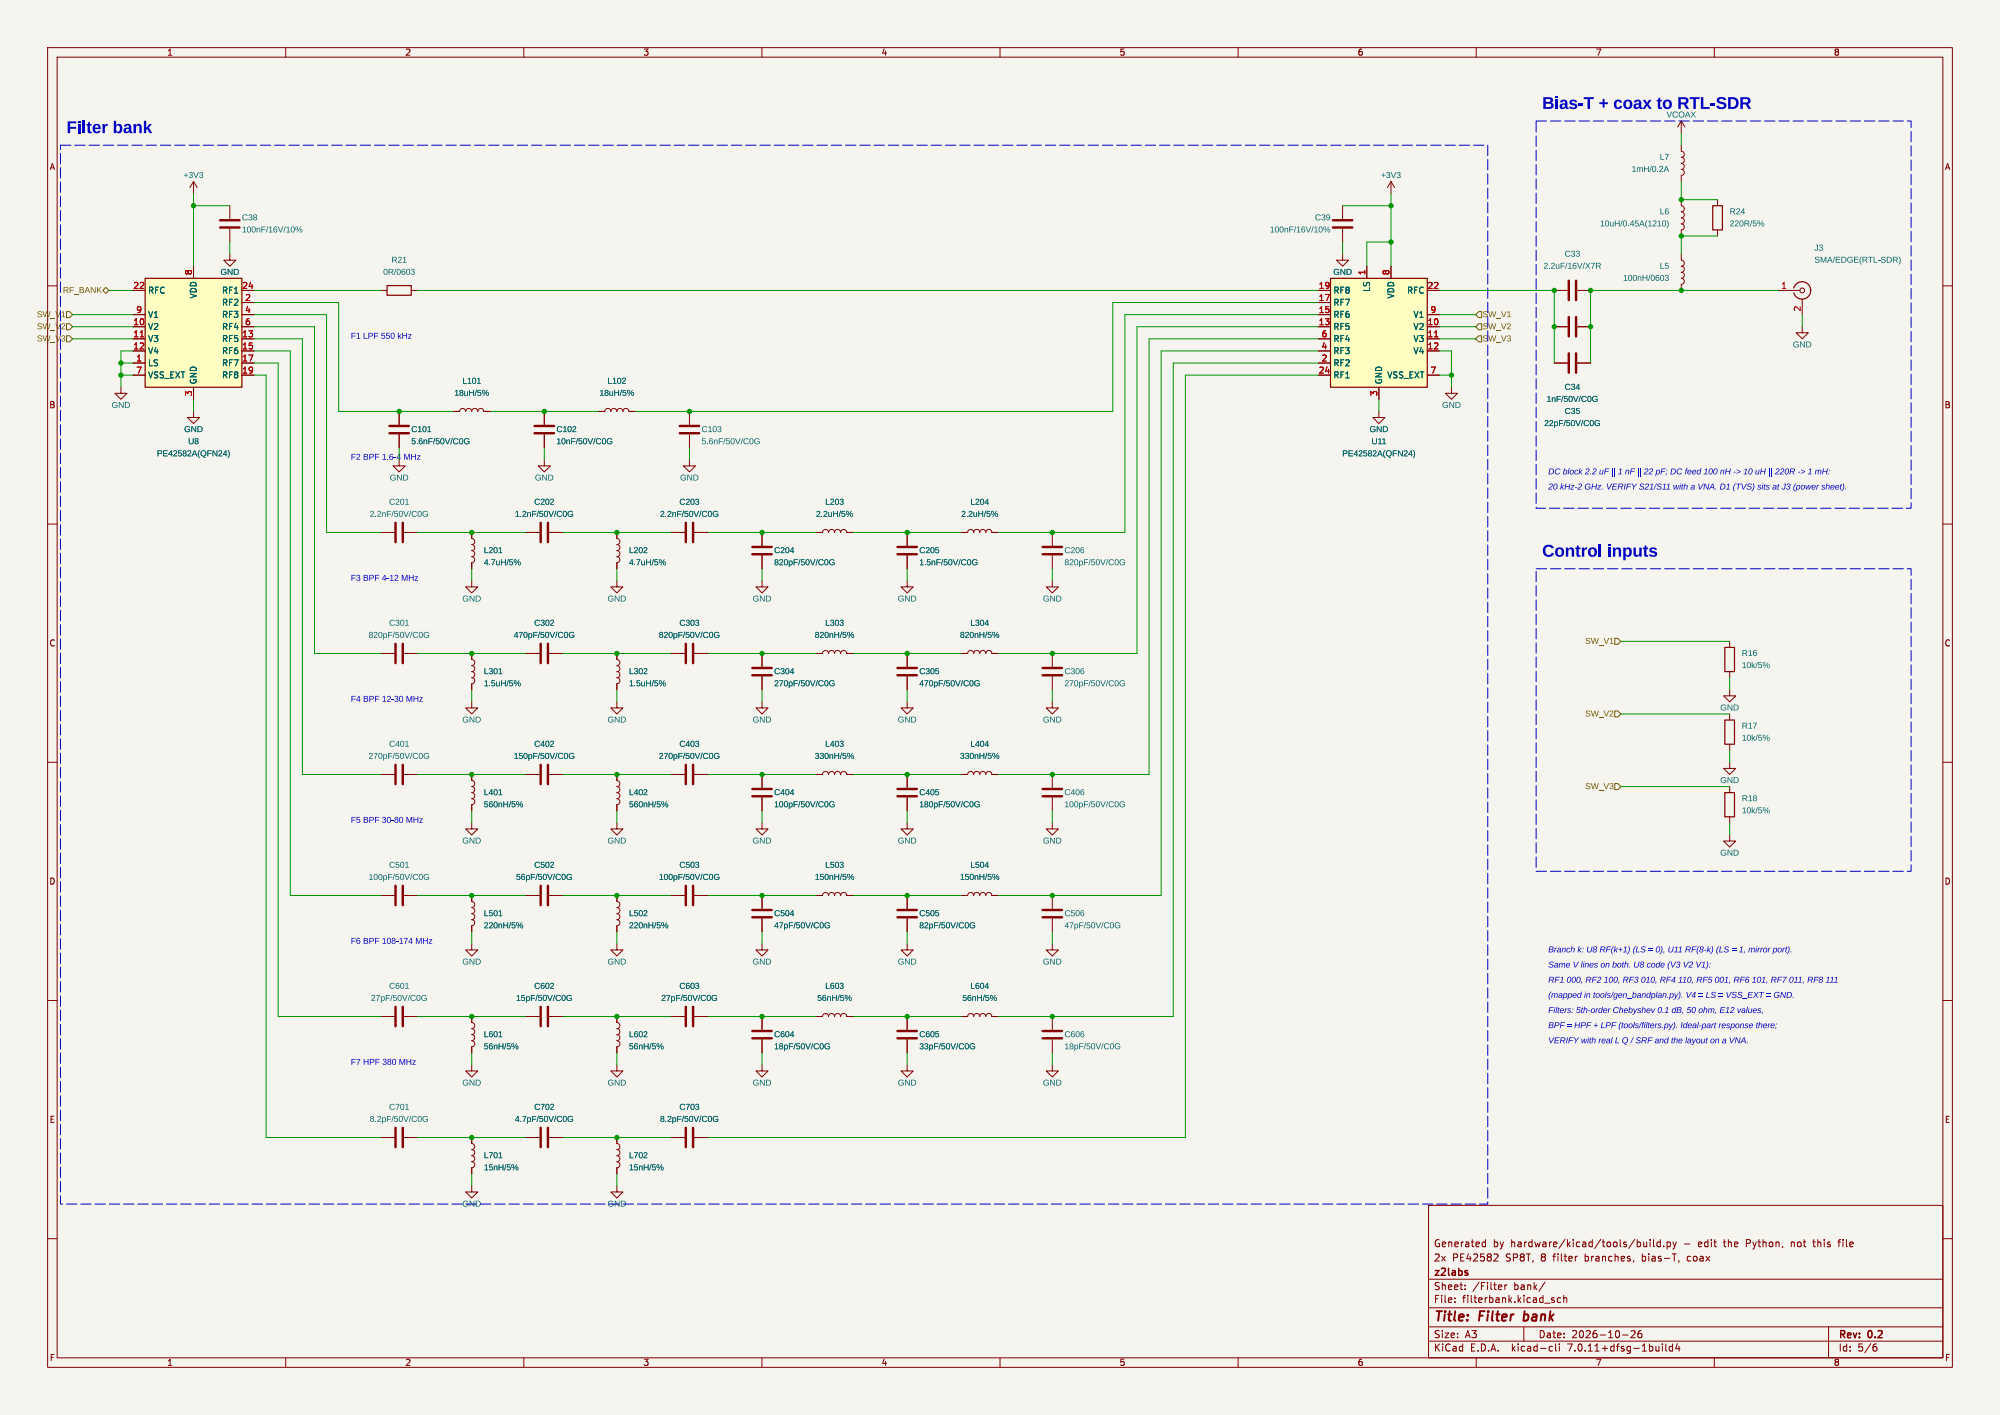
[picture p21: page 5]

Bias-T + coax to RTL-SDR

J3SMA/EDGE(RTL-SDR) GND

8 V1 9 U11 PE42582A(QFN24) GND GND GND GND

F2 BPF 1.6-4 MHz F1 LPF 550 kHz

20 kHz-2 GHz. VERIFY S21/S11 with a VNA. D1 (TVS) sits at J3 (power sheet).

Same V lines on both. U8 code (V3 V2 V1): Filters: 5th-order Chebyshev 0.1 dB, 50 ohm, E12 values, (mapped in tools/gen_bandplan.py). V4 = LS = VSS_EXT = GND. Control inputs

RF1 000, RF2 100, RF3 010, RF4 110, RF5 001, RF6 101, RF7 011, RF8 111 BPF = HPF + LPF (tools/filters.py). Ideal-part response there; VERIFY with real L Q / SRF and the layout on a VNA. Branch k: U8 RF(k+1) (LS = 0), U11 RF(8-k) (LS = 1, mirror port).

Id: 5/6 Title: Filter bank

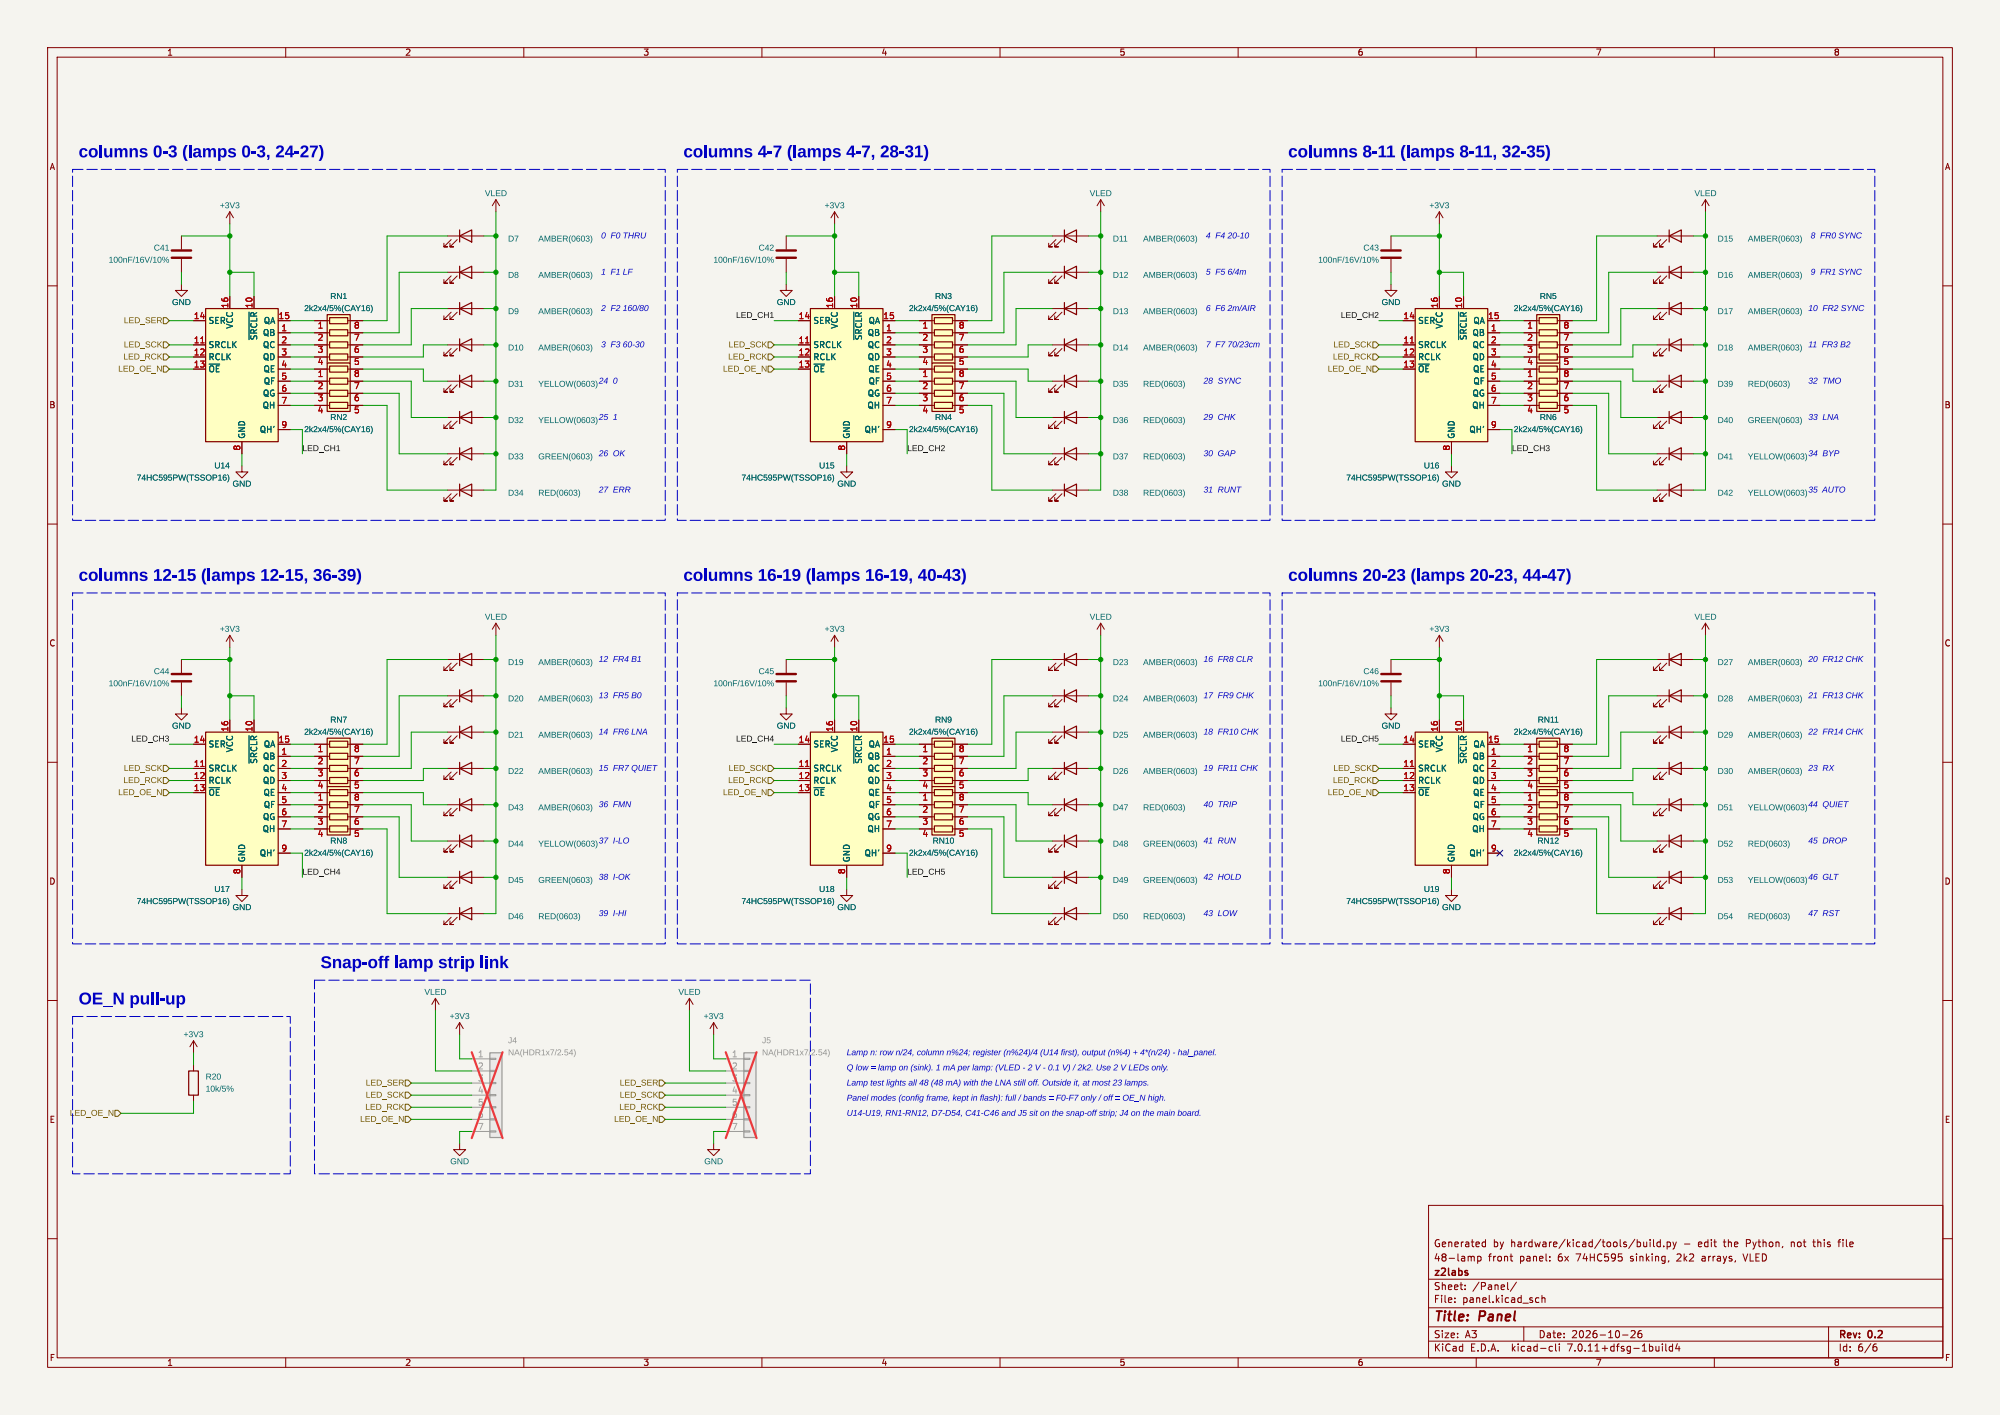
[picture p22: page 6]

8 QH' 9 GND GND GND

20 FR12 CHK Snap-off lamp strip link

Lamp n: row n/24, column n%24; register (n%24)/4 (U14 first), output (n%4) + 4*(n/24) - hal_panel.
Lamp test lights all 48 (48 mA) with the LNA still off. Outside it, at most 23 lamps. Q low = lamp on (sink). 1 mA per lamp: (VLED - 2 V - 0.1 V) / 2k2. Use 2 V LEDs only.

U14-U19, RN1-RN12, D7-D54, C41-C46 and J5 sit on the snap-off strip; J4 on the main board. Panel modes (config frame, kept in flash): full / bands = F0-F7 only / off = OE_N high.

48-lamp | front | by | hardware/kicad/tools/build.py panel: 6x 74HC595 sinking, 2k2 arrays, VLED Generated | - edit the | Python, not | this file

panel.kicad_sch Sheet: /Panel/ z2labs Id: 6/6 Title: Panel File:
