z2labs/coaxolotl/hardware/kicad/coaxolotl.kicad_pcb

## KiCad design hardware/kicad/coaxolotl.kicad_pcb (2026-10-27)

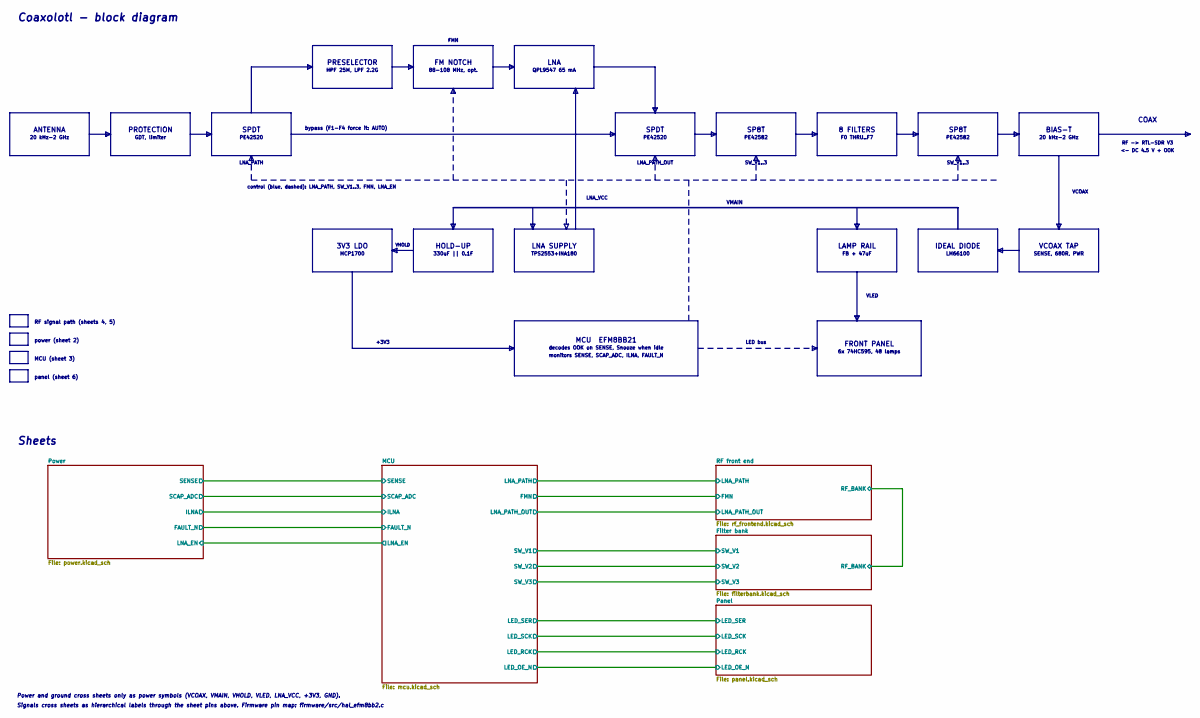
[picture p23: schematic coaxolotl.kicad_sch]

Notes on the sheet:
Coaxolotl - block diagram
ANTENNA
20 kHz-2 GHz
PROTECTION
GDT, limiter
SPDT
PE42520
SP8T
PE42582
8 FILTERS
F0 THRU..F7
BIAS-T
PRESELECTOR
HPF 25M, LPF 2.2G
FM NOTCH
88-108 MHz, opt.
LNA
QPL9547 65 mA
bypass (F1-F4 force it: AUTO)
COAX
RF -> RTL-SDR V3
<- DC 4.5 V + OOK
LNA_PATH
LNA_PATH_OUT
SW_V1..3
FMN
VCOAX TAP
SENSE, 680R, PWR
IDEAL DIODE
LM66100
LAMP RAIL
FB + 47uF
LNA SUPPLY
TPS2553+INA180
HOLD-UP
330uF || 0.1F
3V3 LDO
MCP1700
VCOAX
VMAIN
VHOLD
LNA_VCC
MCU EFM8BB21
decodes OOK on SENSE, Snooze when idle
monitors SENSE, SCAP_ADC, ILNA, FAULT_N
FRONT PANEL
6x 74HC595, 48 lamps
VLED
LED bus
+3V3
control (blue, dashed): LNA_PATH, SW_V1..3, FMN, LNA_EN
RF signal path (sheets 4, 5)
power (sheet 2)
MCU (sheet 3)
panel (sheet 6)
Sheets
Power and ground cross sheets only as power symbols (VCOAX, VMAIN, VHOLD, VLED, LNA_VCC, +3V3, GND).
Signals cross sheets as hierarchical labels through the sheet pins above. Firmware pin map: firmware/src/hal_efm8bb2.c

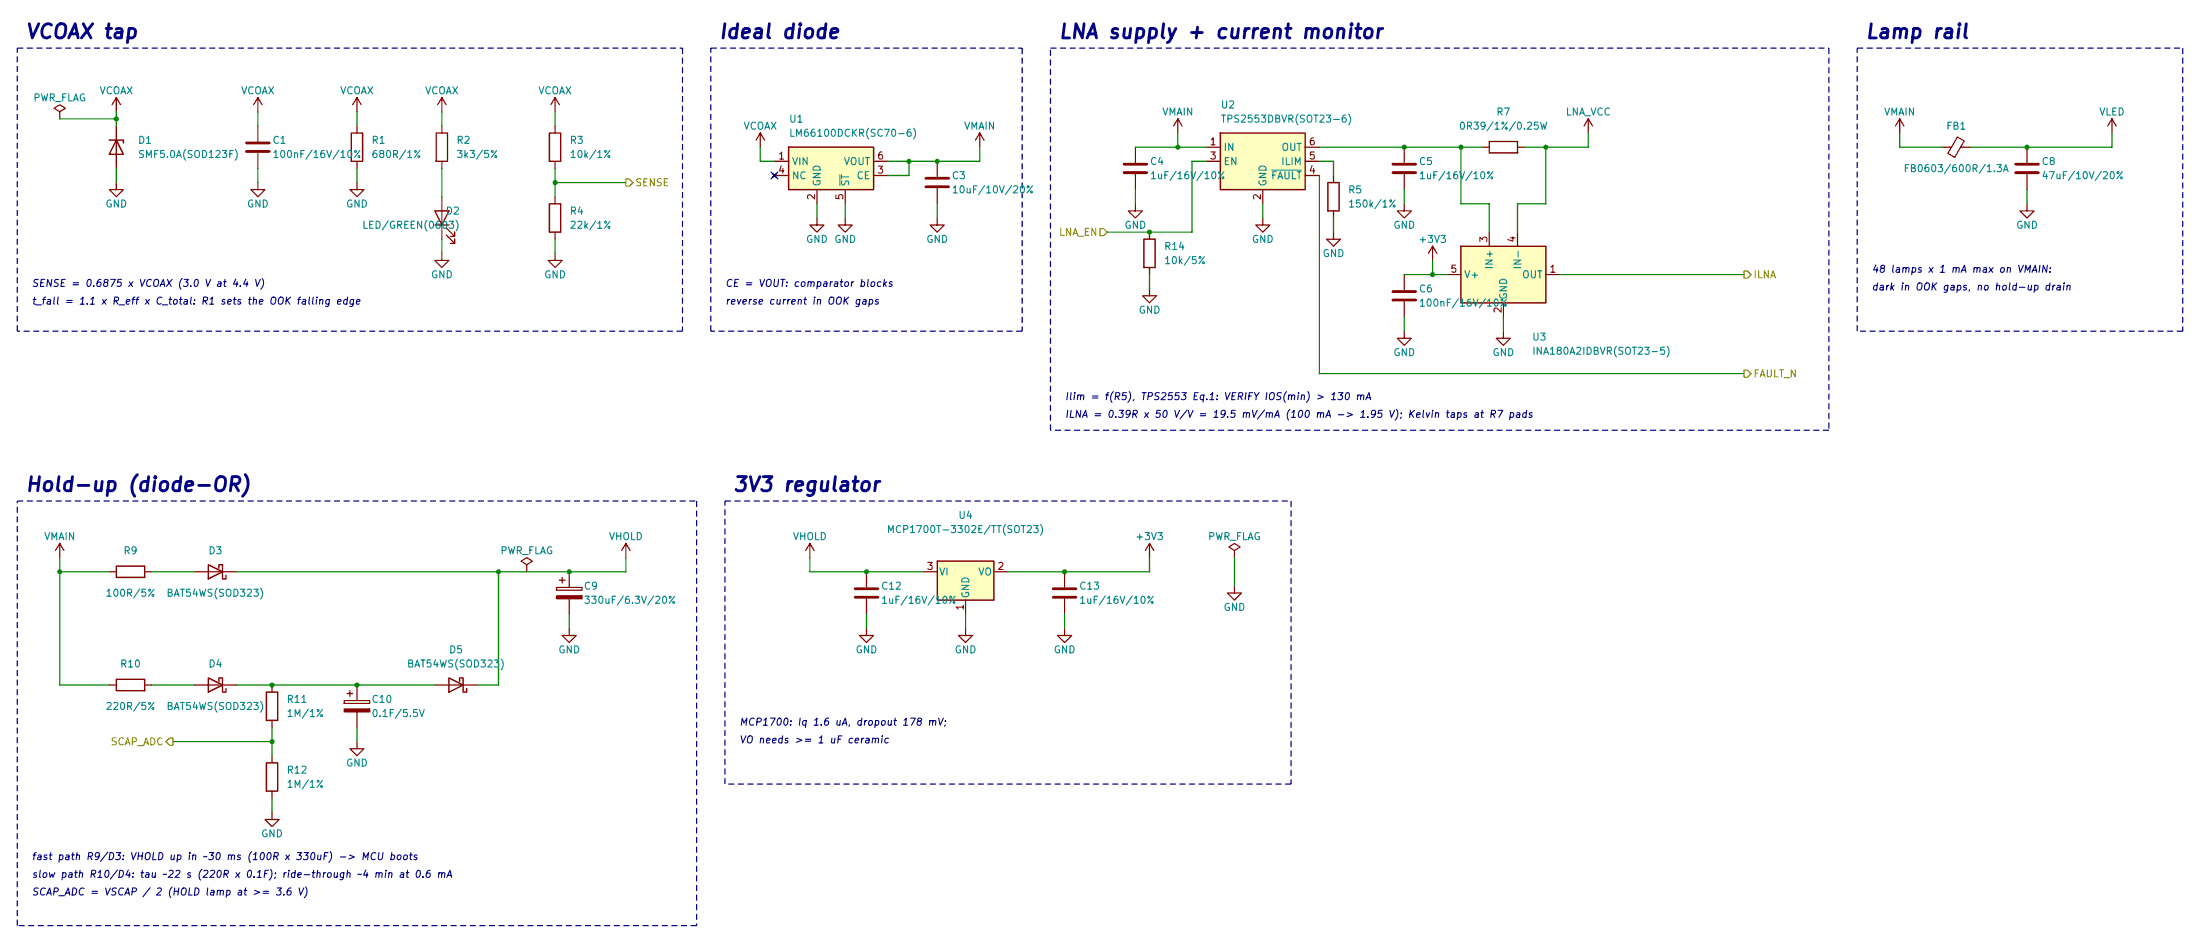
[picture p24: schematic power.kicad_sch]

Parts:
C1, C6: 100nF/16V/10%; C_0603_1608Metric
C3: 10uF/10V/20%; C_0805_2012Metric
C4, C5, C12, C13: 1uF/16V/10%; C_0603_1608Metric
C8: 47uF/10V/20%; C_1206_3216Metric
C9: 330uF/6.3V/20%; CP_EIA-7343-31_Kemet-D; MPN T520D337M006ATE025
C10: 0.1F/5.5V; CP_Radial_D13.0mm_P5.00mm; MPN KR-5R5V104-R
D1: SMF5.0A(SOD123F); D_SOD-123F
D2: LED/GREEN(0603); LED_0603_1608Metric
D3, D4, D5: BAT54WS(SOD323); D_SOD-323
FB1: FB0603/600R/1.3A; L_0603_1608Metric; MPN BLM18KG601SN1D
R1: 680R/1%; R_0603_1608Metric
R2: 3k3/5%; R_0603_1608Metric
R3: 10k/1%; R_0603_1608Metric
R4: 22k/1%; R_0603_1608Metric
R5: 150k/1%; R_0603_1608Metric
R7: 0R39/1%/0.25W; R_1206_3216Metric; MPN ERJ-8BQFR39V
R9: 100R/5%; R_0603_1608Metric
R10: 220R/5%; R_0603_1608Metric
R11, R12: 1M/1%; R_0603_1608Metric
R14: 10k/5%; R_0603_1608Metric
U1: LM66100DCKR(SC70-6); SOT-363_SC-70-6
U2: TPS2553DBVR(SOT23-6); SOT-23-6
U3: INA180A2IDBVR(SOT23-5); SOT-23-5
U4: MCP1700T-3302E/TT(SOT23); SOT-23

Connections:
+3V3: C6.1, C13.1, U3.5 (V+), U4.2 (VO); also elsewhere on the board
/MCU/FAULT_N: U2.4 (~FAULT); also elsewhere on the board
/MCU/ILNA: U3.1 (OUT); also elsewhere on the board
/MCU/LNA_EN: R14.1, U2.3 (EN); also elsewhere on the board
/MCU/SCAP_ADC: R11.2, R12.1; also elsewhere on the board
/MCU/SENSE: R3.2, R4.1; also elsewhere on the board
GND: C1.2, C3.2, C4.2, C5.2, C6.2, C8.2, C9.2, C10.2, C12.2, C13.2, D1.2 (A), D2.1 (K), R1.2, R4.2, R5.2, R12.2, R14.2, U1.2 (GND), U1.5 (~ST), U2.2 (GND), U3.2 (GND), U4.1 (GND); also elsewhere on the board
LNA_VCC: R7.2, U3.4 (IN-); also elsewhere on the board
unnamed: D2.2 (A), R2.2
unnamed: D3.2 (A), R9.2
unnamed: D4.2 (A), R10.2
unnamed: C10.1, D4.1 (K), D5.2 (A), R11.1
unnamed: R5.1, U2.5 (ILIM)
unnamed: C5.1, R7.1, U2.6 (OUT), U3.3 (IN+)
VCOAX: C1.1, D1.1 (K), R1.1, R2.1, R3.1, U1.1 (VIN); also elsewhere on the board
VHOLD: C9.1, C12.1, D3.1 (K), D5.1 (K), U4.3 (VI)
VLED: C8.1, FB1.2; also elsewhere on the board
VMAIN: C3.1, C4.1, FB1.1, R9.1, R10.1, U1.3 (CE), U1.6 (VOUT), U2.1 (IN)

Notes on the sheet:
VCOAX tap
SENSE = 0.6875 x VCOAX (3.0 V at 4.4 V)
t_fall = 1.1 x R_eff x C_total: R1 sets the OOK falling edge
Ideal diode
CE = VOUT: comparator blocks
reverse current in OOK gaps
LNA supply + current monitor
Ilim = f(R5), TPS2553 Eq.1: VERIFY IOS(min) > 130 mA
ILNA = 0.39R x 50 V/V = 19.5 mV/mA (100 mA -> 1.95 V); Kelvin taps at R7 pads
Lamp rail
48 lamps x 1 mA max on VMAIN:
dark in OOK gaps, no hold-up drain
Hold-up (diode-OR)
fast path R9/D3: VHOLD up in ~30 ms (100R x 330uF) -> MCU boots
slow path R10/D4: tau ~22 s (220R x 0.1F); ride-through ~4 min at 0.6 mA
SCAP_ADC = VSCAP / 2 (HOLD lamp at >= 3.6 V)
3V3 regulator
MCP1700: Iq 1.6 uA, dropout 178 mV;
VO needs >= 1 uF ceramic

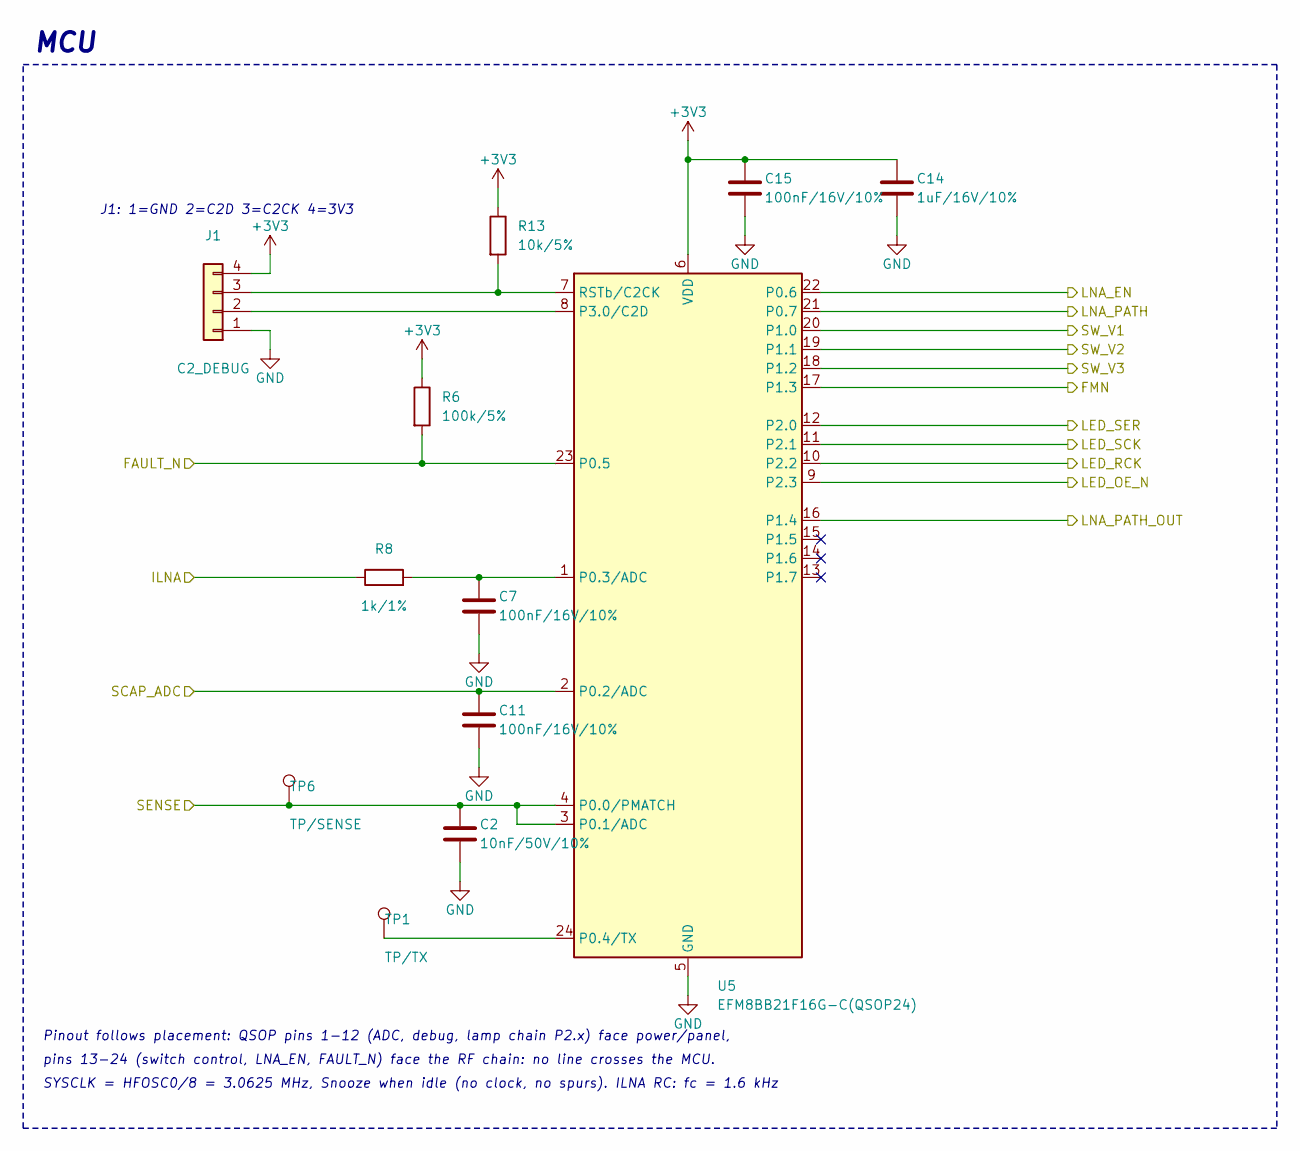
[picture p25: schematic mcu.kicad_sch]

Parts:
C2: 10nF/50V/10%; C_0603_1608Metric
C7, C11, C15: 100nF/16V/10%; C_0603_1608Metric
C14: 1uF/16V/10%; C_0603_1608Metric
J1: C2_DEBUG; PinHeader_1x04_P2.54mm_Vertical
R6: 100k/5%; R_0603_1608Metric
R8: 1k/1%; R_0603_1608Metric
R13: 10k/5%; R_0603_1608Metric
TP1: TP/TX; TestPoint_Pad_D1.0mm
TP6: TP/SENSE; TestPoint_Pad_D1.0mm
U5: EFM8BB21F16G-C(QSOP24); QSOP-24_3.9x8.7mm_P0.635mm

Connections:
+3V3: C14.1, C15.1, J1.4, R6.1, R13.1, U5.6 (VDD); also elsewhere on the board
/Filter bank/SW_V1: U5.20 (P1.0); also elsewhere on the board
/Filter bank/SW_V2: U5.19 (P1.1); also elsewhere on the board
/Filter bank/SW_V3: U5.18 (P1.2); also elsewhere on the board
/MCU/FAULT_N: R6.2, U5.23 (P0.5); also elsewhere on the board
/MCU/FMN: U5.17 (P1.3); also elsewhere on the board
/MCU/ILNA: R8.1; also elsewhere on the board
/MCU/LED_OE_N: U5.9 (P2.3); also elsewhere on the board
/MCU/LED_RCK: U5.10 (P2.2); also elsewhere on the board
/MCU/LED_SCK: U5.11 (P2.1); also elsewhere on the board
/MCU/LED_SER: U5.12 (P2.0); also elsewhere on the board
/MCU/LNA_EN: U5.22 (P0.6); also elsewhere on the board
/MCU/LNA_PATH: U5.21 (P0.7); also elsewhere on the board
/MCU/LNA_PATH_OUT: U5.16 (P1.4); also elsewhere on the board
/MCU/SCAP_ADC: C11.1, U5.2 (P0.2/ADC); also elsewhere on the board
/MCU/SENSE: C2.1, TP6.1, U5.3 (P0.1/ADC), U5.4 (P0.0/PMATCH); also elsewhere on the board
GND: C2.2, C7.2, C11.2, C14.2, C15.2, J1.1, U5.5 (GND); also elsewhere on the board
unnamed: J1.2, U5.8 (P3.0/C2D)
unnamed: J1.3, R13.2, U5.7 (RSTb/C2CK)
unnamed: C7.1, R8.2, U5.1 (P0.3/ADC)
unnamed: TP1.1, U5.24 (P0.4/TX)

Notes on the sheet:
MCU
J1: 1=GND 2=C2D 3=C2CK 4=3V3
Pinout follows placement: QSOP pins 1-12 (ADC, debug, lamp chain P2.x) face power/panel,
pins 13-24 (switch control, LNA_EN, FAULT_N) face the RF chain: no line crosses the MCU.
SYSCLK = HFOSC0/8 = 3.0625 MHz, Snooze when idle (no clock, no spurs). ILNA RC: fc = 1.6 kHz

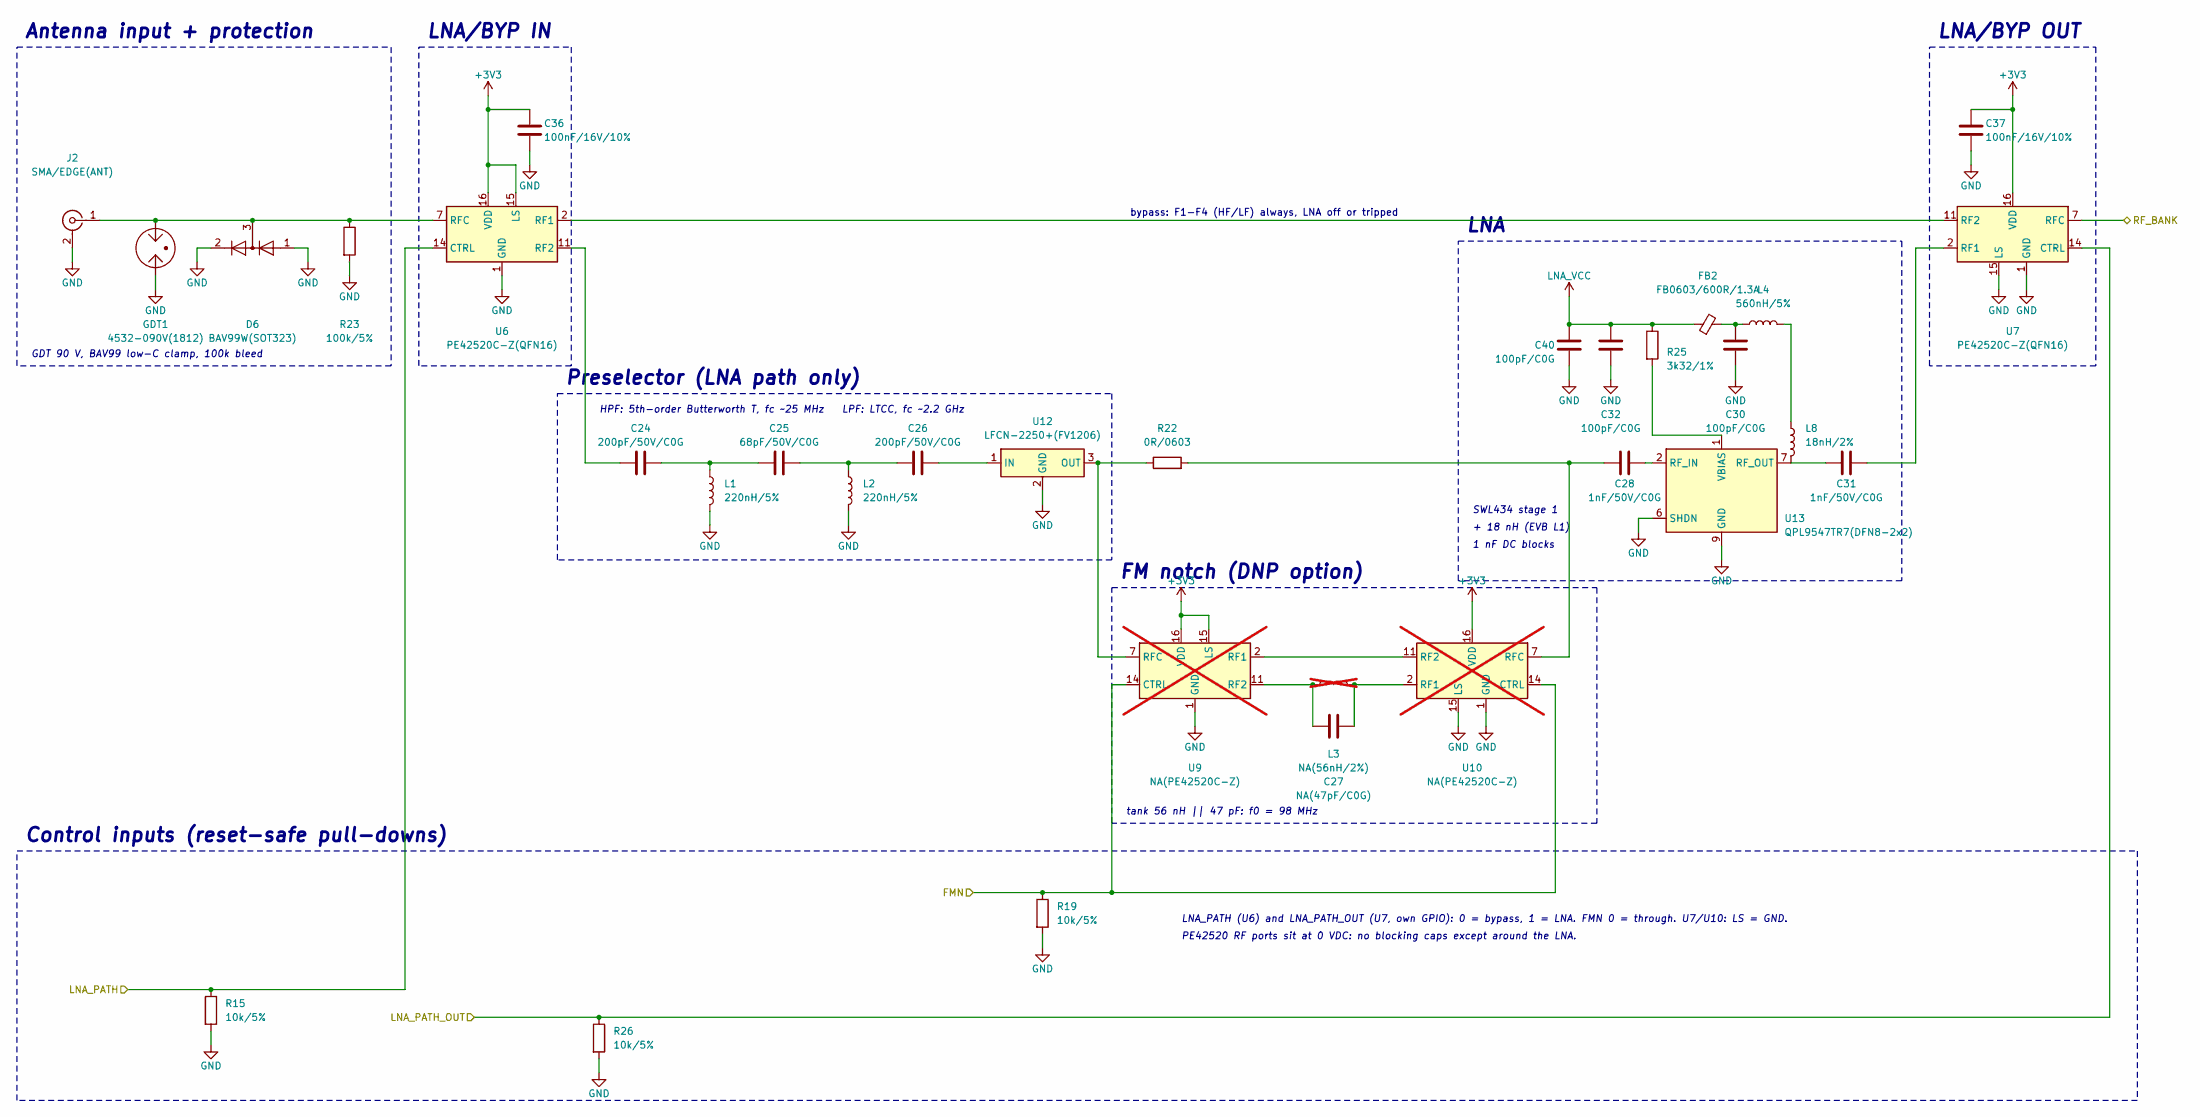
[picture p26: schematic rf_frontend.kicad_sch, RF front end]

Parts:
C24, C26: 200pF/50V/C0G; C_0603_1608Metric
C25: 68pF/50V/C0G; C_0603_1608Metric
C27: NA(47pF/C0G); C_0603_1608Metric
C28, C31: 1nF/50V/C0G; C_0603_1608Metric
C30, C32, C40: 100pF/C0G; C_0603_1608Metric
C36, C37: 100nF/16V/10%; C_0603_1608Metric
D6: BAV99W(SOT323); SOT-323_SC-70
FB2: FB0603/600R/1.3A; L_0603_1608Metric
GDT1: 4532-090V(1812); GDT_SMD_1812; MPN 4532-090V; LCSC C476204
J2: SMA/EDGE(ANT); SMA_Amphenol_132289_EdgeMount
L1, L2: 220nH/5%; L_0603_1608Metric
L3: NA(56nH/2%); L_0603_1608Metric; not fitted
L4: 560nH/5%; L_0603_1608Metric
L8: 18nH/2%; L_0603_1608Metric
R15, R19, R26: 10k/5%; R_0603_1608Metric
R22: 0R/0603; R_0603_1608Metric
R23: 100k/5%; R_0603_1608Metric
R25: 3k32/1%; R_0603_1608Metric
U6, U7: PE42520C-Z(QFN16); QFN-16-1EP_3x3mm_P0.5mm_EP1.7x1.7mm
U9, U10: NA(PE42520C-Z); QFN-16-1EP_3x3mm_P0.5mm_EP1.7x1.7mm; not fitted
U12: LFCN-2250+(FV1206); MiniCircuits_FV1206
U13: QPL9547TR7(DFN8-2x2); DFN-8-1EP_2x2mm_P0.5mm_EP0.8x1.6mm; LCSC C5367093

Connections:
+3V3: C36.1, C37.1, U6.15 (LS), U6.16 (VDD), U7.16 (VDD), U9.15 (LS), U9.16 (VDD), U10.16 (VDD); also elsewhere on the board
/Filter bank/RF_BANK: U7.7 (RFC); also elsewhere on the board
/MCU/FMN: R19.1, U9.14 (CTRL), U10.14 (CTRL); also elsewhere on the board
/MCU/LNA_PATH: R15.1, U6.14 (CTRL); also elsewhere on the board
/MCU/LNA_PATH_OUT: R26.1, U7.14 (CTRL); also elsewhere on the board
GND: C30.2, C32.2, C36.2, C37.2, C40.2, D6.1 (K), D6.2 (A), GDT1.1, J2.2 (Ext), L1.2, L2.2, R15.2, R19.2, R23.2, R26.2, U6.1 (GND), U6.3 (GND), U6.4 (GND), U6.5 (GND), U6.6 (GND), U6.8 (GND), U6.9 (GND), U6.10 (GND), U6.12 (GND), U6.13 (GND), U6.17 (GND), U7.1 (GND), U7.3 (GND), U7.4 (GND), U7.5 (GND), U7.6 (GND), U7.8 (GND), U7.9 (GND), U7.10 (GND), U7.12 (GND), U7.13 (GND), U7.15 (LS), U7.17 (GND), U9.1 (GND), U9.3 (GND), U9.4 (GND), U9.5 (GND), U9.6 (GND), U9.8 (GND), U9.9 (GND), U9.10 (GND), U9.12 (GND), U9.13 (GND), U9.17 (GND), U10.1 (GND), U10.3 (GND), U10.4 (GND), U10.5 (GND), U10.6 (GND), U10.8 (GND), U10.9 (GND), U10.10 (GND), U10.12 (GND), U10.13 (GND), U10.15 (LS), U10.17 (GND), U12.2 (GND), U12.4 (GND), U13.4 (GND), U13.5 (GND), U13.6 (SHDN), U13.8 (GND), U13.9 (GND); also elsewhere on the board
LNA_VCC: C32.1, C40.1, FB2.1, R25.1; also elsewhere on the board
unnamed: C24.2, C25.1, L1.1
unnamed: C25.2, C26.1, L2.1
unnamed: C30.1, FB2.2, L4.1
unnamed: D6.3 (K), GDT1.3, J2.1 (In), R23.1, U6.7 (RFC)
unnamed: L4.2, L8.1
unnamed: U6.2 (RF1), U7.11 (RF2)
unnamed: C24.1, U6.11 (RF2)
unnamed: C31.2, U7.2 (RF1)
unnamed: C27.1, L3.1, U9.11 (RF2)
unnamed: C27.2, L3.2, U10.2 (RF1)
unnamed: U9.2 (RF1), U10.11 (RF2)
unnamed: C28.1, R22.2, U10.7 (RFC)
unnamed: C26.2, U12.1 (IN)
unnamed: R22.1, U9.7 (RFC), U12.3 (OUT)
unnamed: C28.2, U13.2 (RF_IN)
unnamed: C31.1, L8.2, U13.7 (RF_OUT)
unnamed: R25.2, U13.1 (VBIAS)

Notes on the sheet:
Antenna input + protection
GDT 90 V, BAV99 low-C clamp, 100k bleed
LNA/BYP IN
Preselector (LNA path only)
HPF: 5th-order Butterworth T, fc ~25 MHz
LPF: LTCC, fc ~2.2 GHz
FM notch (DNP option)
tank 56 nH || 47 pF: f0 = 98 MHz
LNA
SWL434 stage 1
+ 18 nH (EVB L1)
1 nF DC blocks
LNA/BYP OUT
bypass: F1-F4 (HF/LF) always, LNA off or tripped
Control inputs (reset-safe pull-downs)
LNA_PATH (U6) and LNA_PATH_OUT (U7, own GPIO): 0 = bypass, 1 = LNA. FMN 0 = through. U7/U10: LS = GND.
PE42520 RF ports sit at 0 VDC: no blocking caps except around the LNA.

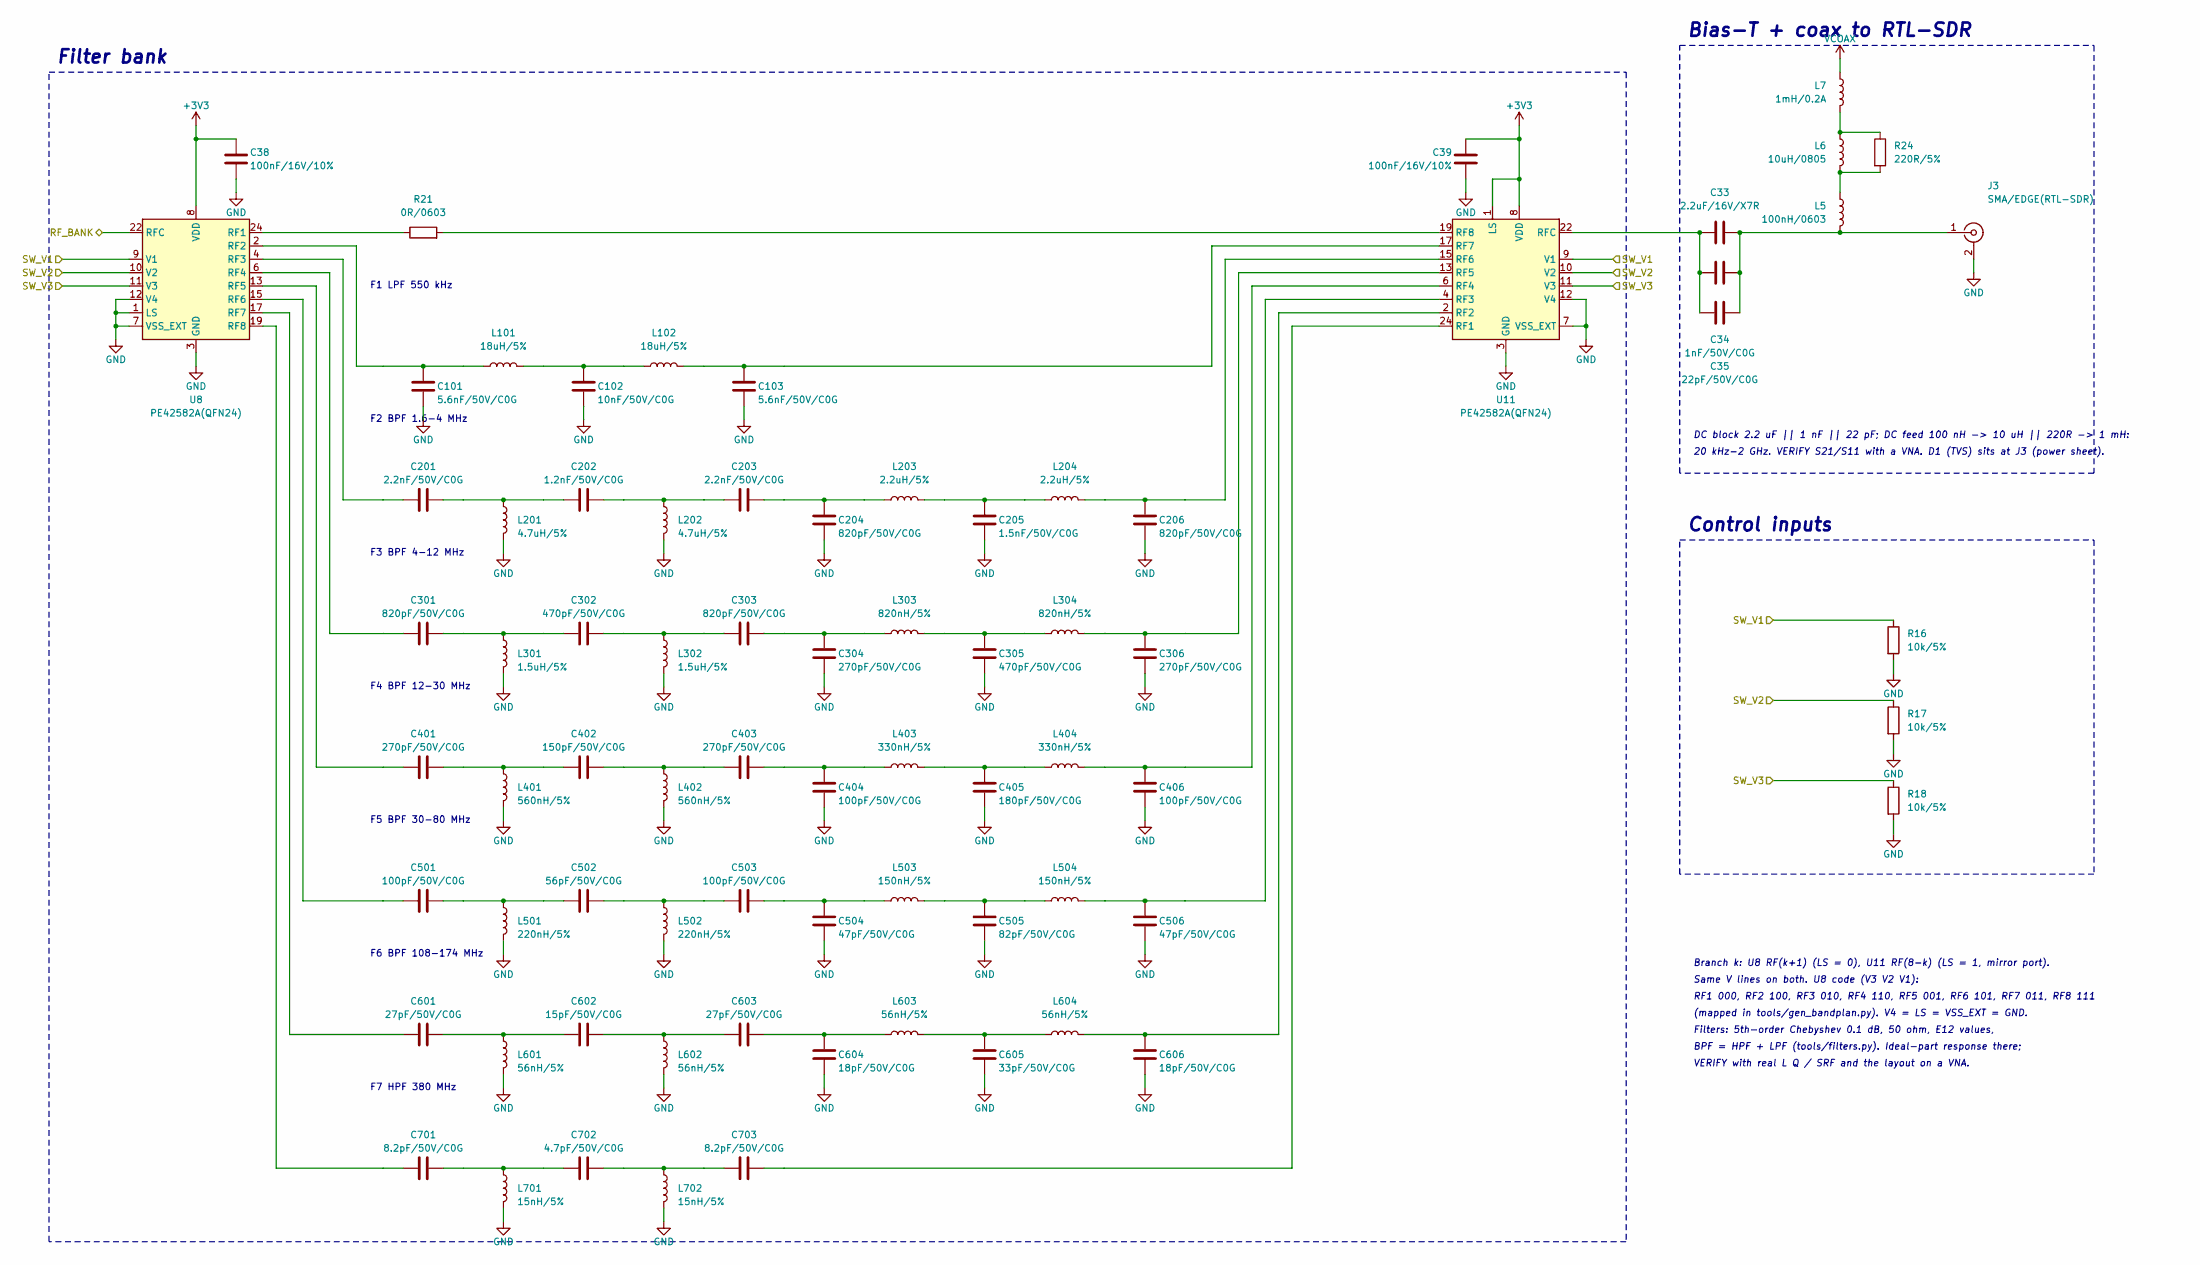
[picture p27: schematic filterbank.kicad_sch, Filter bank]

Parts:
C33: 2.2uF/16V/X7R; C_0805_2012Metric
C34: 1nF/50V/C0G; C_0603_1608Metric
C35: 22pF/50V/C0G; C_0603_1608Metric
C38, C39: 100nF/16V/10%; C_0603_1608Metric
C101, C103: 5.6nF/50V/C0G; C_0603_1608Metric
C102: 10nF/50V/C0G; C_0603_1608Metric
C201, C203: 2.2nF/50V/C0G; C_0603_1608Metric
C202: 1.2nF/50V/C0G; C_0603_1608Metric
C204, C206, C301, C303: 820pF/50V/C0G; C_0603_1608Metric
C205: 1.5nF/50V/C0G; C_0603_1608Metric
C302, C305: 470pF/50V/C0G; C_0603_1608Metric
C304, C306, C401, C403: 270pF/50V/C0G; C_0603_1608Metric
C402: 150pF/50V/C0G; C_0603_1608Metric
C404, C406, C501, C503: 100pF/50V/C0G; C_0603_1608Metric
C405: 180pF/50V/C0G; C_0603_1608Metric
C502: 56pF/50V/C0G; C_0603_1608Metric
C504, C506: 47pF/50V/C0G; C_0603_1608Metric
C505: 82pF/50V/C0G; C_0603_1608Metric
C601, C603: 27pF/50V/C0G; C_0603_1608Metric
C602: 15pF/50V/C0G; C_0603_1608Metric
C604, C606: 18pF/50V/C0G; C_0603_1608Metric
C605: 33pF/50V/C0G; C_0603_1608Metric
C701, C703: 8.2pF/50V/C0G; C_0603_1608Metric
C702: 4.7pF/50V/C0G; C_0603_1608Metric
J3: SMA/EDGE(RTL-SDR); SMA_Amphenol_132289_EdgeMount
L5: 100nH/0603; L_0603_1608Metric
L6: 10uH/0805; L_0805_2012Metric
L7: 1mH/0.2A; L_Bourns_SRR1260; MPN SRR1260-102M
L101, L102: 18uH/5%; L_1210_3225Metric
L201, L202: 4.7uH/5%; L_0805_2012Metric
L203, L204: 2.2uH/5%; L_0805_2012Metric
L301, L302: 1.5uH/5%; L_0805_2012Metric
L303, L304: 820nH/5%; L_0805_2012Metric
L401, L402: 560nH/5%; L_0805_2012Metric
L403, L404: 330nH/5%; L_0603_1608Metric
L501, L502: 220nH/5%; L_0603_1608Metric
L503, L504: 150nH/5%; L_0603_1608Metric
L601, L602, L603, L604: 56nH/5%; L_0603_1608Metric
L701, L702: 15nH/5%; L_0603_1608Metric
R16, R17, R18: 10k/5%; R_0603_1608Metric
R21: 0R/0603; R_0603_1608Metric
R24: 220R/5%; R_0603_1608Metric
U8, U11: PE42582A(QFN24); QFN-24-1EP_4x4mm_P0.5mm_EP2.6x2.6mm

Connections:
+3V3: C38.1, C39.1, U8.8 (VDD), U11.1 (LS), U11.8 (VDD); also elsewhere on the board
/Filter bank/RF_BANK: U8.22 (RFC); also elsewhere on the board
/Filter bank/SW_V1: R16.1, U8.9 (V1), U11.9 (V1); also elsewhere on the board
/Filter bank/SW_V2: R17.1, U8.10 (V2), U11.10 (V2); also elsewhere on the board
/Filter bank/SW_V3: R18.1, U8.11 (V3), U11.11 (V3); also elsewhere on the board
GND: C38.2, C39.2, C101.2, C102.2, C103.2, C204.2, C205.2, C206.2, C304.2, C305.2, C306.2, C404.2, C405.2, C406.2, C504.2, C505.2, C506.2, C604.2, C605.2, C606.2, J3.2 (Ext), L201.2, L202.2, L301.2, L302.2, L401.2, L402.2, L501.2, L502.2, L601.2, L602.2, L701.2, L702.2, R16.2, R17.2, R18.2, U8.1 (LS), U8.3 (GND), U8.5 (GND), U8.7 (VSS_EXT), U8.12 (V4), U8.14 (GND), U8.16 (GND), U8.18 (GND), U8.20 (GND), U8.21 (GND), U8.23 (GND), U8.25 (GND), U11.3 (GND), U11.5 (GND), U11.7 (VSS_EXT), U11.12 (V4), U11.14 (GND), U11.16 (GND), U11.18 (GND), U11.20 (GND), U11.21 (GND), U11.23 (GND), U11.25 (GND); also elsewhere on the board
unnamed: C102.1, L101.2, L102.1
unnamed: C201.2, C202.1, L201.1
unnamed: C202.2, C203.1, L202.1
unnamed: C203.2, C204.1, L203.1
unnamed: C205.1, L203.2, L204.1
unnamed: C301.2, C302.1, L301.1
unnamed: C302.2, C303.1, L302.1
unnamed: C303.2, C304.1, L303.1
unnamed: C305.1, L303.2, L304.1
unnamed: C401.2, C402.1, L401.1
unnamed: C402.2, C403.1, L402.1
unnamed: C403.2, C404.1, L403.1
unnamed: C405.1, L403.2, L404.1
unnamed: C501.2, C502.1, L501.1
unnamed: C502.2, C503.1, L502.1
unnamed: C503.2, C504.1, L503.1
unnamed: C505.1, L503.2, L504.1
unnamed: C601.2, C602.1, L601.1
unnamed: C602.2, C603.1, L602.1
unnamed: C603.2, C604.1, L603.1
unnamed: C605.1, L603.2, L604.1
unnamed: C701.2, C702.1, L701.1
unnamed: C702.2, C703.1, L702.1
unnamed: C33.2, C34.2, C35.2, J3.1 (In), L5.2
unnamed: L5.1, L6.2, R24.2
unnamed: L6.1, L7.2, R24.1
unnamed: R21.1, U8.24 (RF1)
unnamed: C101.1, L101.1, U8.2 (RF2)
unnamed: C201.1, U8.4 (RF3)
unnamed: C301.1, U8.6 (RF4)
unnamed: C401.1, U8.13 (RF5)
unnamed: C501.1, U8.15 (RF6)
unnamed: C601.1, U8.17 (RF7)
unnamed: C701.1, U8.19 (RF8)
unnamed: C703.2, U11.24 (RF1)
unnamed: C606.1, L604.2, U11.2 (RF2)
unnamed: C506.1, L504.2, U11.4 (RF3)
unnamed: C406.1, L404.2, U11.6 (RF4)
unnamed: C306.1, L304.2, U11.13 (RF5)
unnamed: C206.1, L204.2, U11.15 (RF6)
unnamed: C103.1, L102.2, U11.17 (RF7)
unnamed: R21.2, U11.19 (RF8)
unnamed: C33.1, C34.1, C35.1, U11.22 (RFC)
VCOAX: L7.1; also elsewhere on the board

Notes on the sheet:
Filter bank
F1 LPF 550 kHz
F2 BPF 1.6-4 MHz
F3 BPF 4-12 MHz
F4 BPF 12-30 MHz
F5 BPF 30-80 MHz
F6 BPF 108-174 MHz
F7 HPF 380 MHz
Branch k: U8 RF(k+1) (LS = 0), U11 RF(8-k) (LS = 1, mirror port).
Same V lines on both. U8 code (V3 V2 V1):
RF1 000, RF2 100, RF3 010, RF4 110, RF5 001, RF6 101, RF7 011, RF8 111
(mapped in tools/gen_bandplan.py). V4 = LS = VSS_EXT = GND.
Filters: 5th-order Chebyshev 0.1 dB, 50 ohm, E12 values,
BPF = HPF + LPF (tools/filters.py). Ideal-part response there;
VERIFY with real L Q / SRF and the layout on a VNA.
Bias-T + coax to RTL-SDR
DC block 2.2 uF || 1 nF || 22 pF; DC feed 100 nH -> 10 uH || 220R -> 1 mH:
20 kHz-2 GHz. VERIFY S21/S11 with a VNA. D1 (TVS) sits at J3 (power sheet).
Control inputs
