z2labs/coaxolotl/hardware/kicad/coaxolotl.kicad_pcb

## KiCad design hardware/kicad/coaxolotl.kicad_pcb (continued)

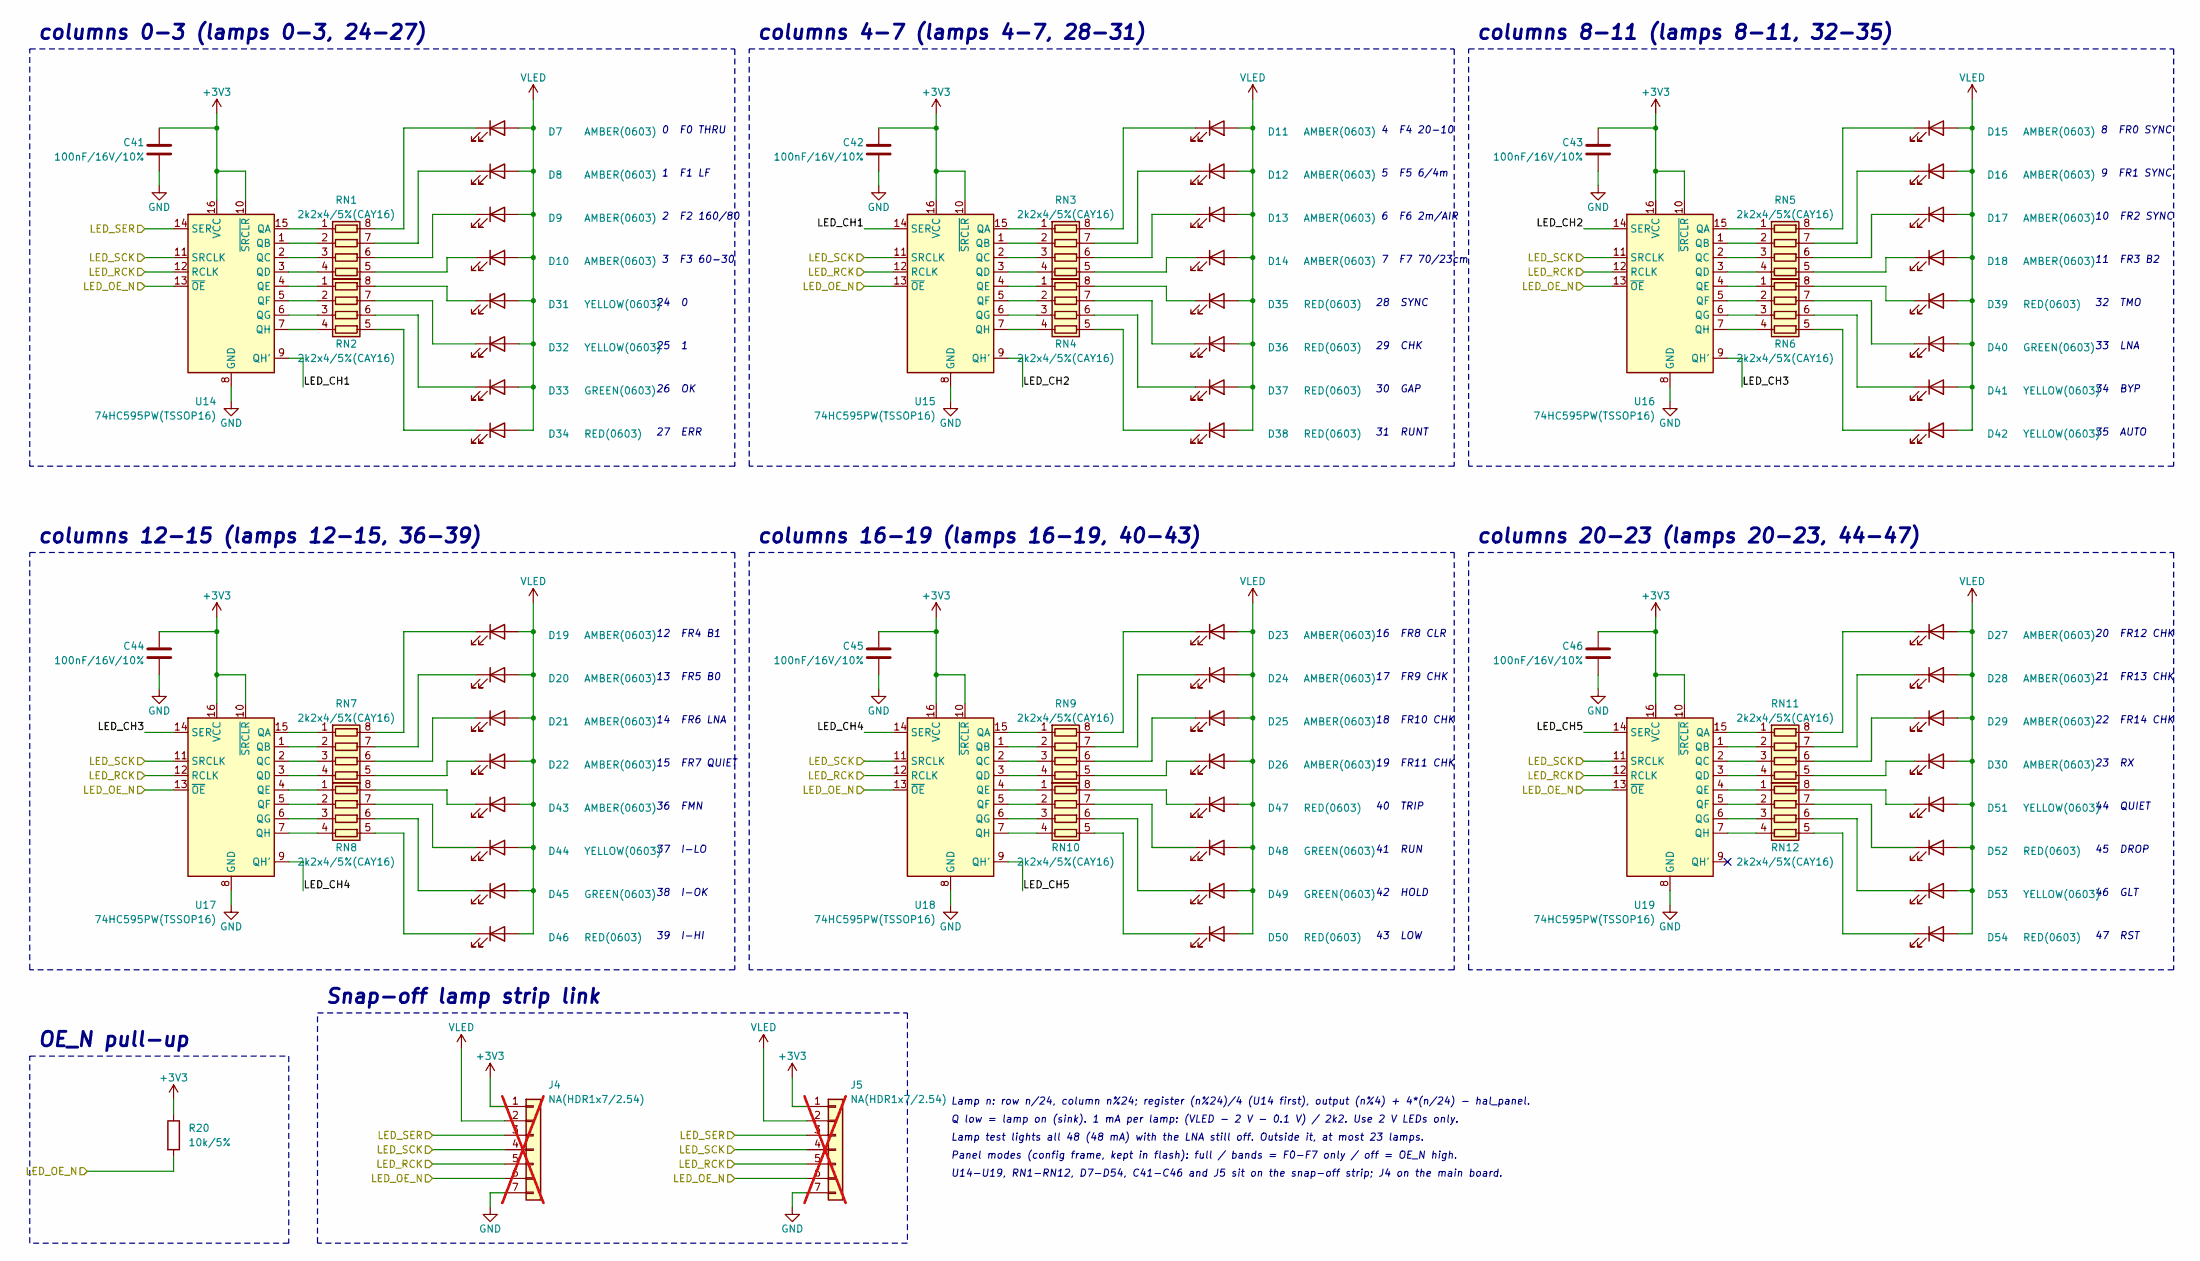
[picture p28: schematic panel.kicad_sch]

Parts:
C41, C42, C43, C44, C45, C46: 100nF/16V/10%; C_0603_1608Metric
D7, D8, D9, D10, D11, D12, D13, D14, D15, D16, D17, D18, D19, D20, D21, D22, D23, D24, D25, D26, D27, D28, D29, D30, D43: AMBER(0603); LED_0603_1608Metric
D31, D32, D41, D42, D44, D51, D53: YELLOW(0603); LED_0603_1608Metric
D33, D40, D45, D48, D49: GREEN(0603); LED_0603_1608Metric
D34, D35, D36, D37, D38, D39, D46, D47, D50, D52, D54: RED(0603); LED_0603_1608Metric
J4, J5: NA(HDR1x7/2.54); PinHeader_1x07_P2.54mm_Vertical; not fitted
R20: 10k/5%; R_0603_1608Metric
RN1, RN2, RN3, RN4, RN5, RN6, RN7, RN8, RN9, RN10, RN11, RN12: 2k2x4/5%(CAY16); R_Array_Convex_4x0603; MPN CAY16-222J4LF
U14, U15, U16, U17, U18, U19: 74HC595PW(TSSOP16); TSSOP-16_4.4x5mm_P0.65mm

Connections:
+3V3: C41.1, C42.1, C43.1, C44.1, C45.1, C46.1, J4.1, J5.1, R20.1, U14.10 (~SRCLR), U14.16 (VCC), U15.10 (~SRCLR), U15.16 (VCC), U16.10 (~SRCLR), U16.16 (VCC), U17.10 (~SRCLR), U17.16 (VCC), U18.10 (~SRCLR), U18.16 (VCC), U19.10 (~SRCLR), U19.16 (VCC); also elsewhere on the board
/MCU/LED_OE_N: J4.6, J5.6, R20.2, U14.13 (~OE), U15.13 (~OE), U16.13 (~OE), U17.13 (~OE), U18.13 (~OE), U19.13 (~OE); also elsewhere on the board
/MCU/LED_RCK: J4.5, J5.5, U14.12 (RCLK), U15.12 (RCLK), U16.12 (RCLK), U17.12 (RCLK), U18.12 (RCLK), U19.12 (RCLK); also elsewhere on the board
/MCU/LED_SCK: J4.4, J5.4, U14.11 (SRCLK), U15.11 (SRCLK), U16.11 (SRCLK), U17.11 (SRCLK), U18.11 (SRCLK), U19.11 (SRCLK); also elsewhere on the board
/MCU/LED_SER: J4.3, J5.3, U14.14 (SER); also elsewhere on the board
/Panel/LED_CH1: U14.9 (QH'), U15.14 (SER)
/Panel/LED_CH2: U15.9 (QH'), U16.14 (SER)
/Panel/LED_CH3: U16.9 (QH'), U17.14 (SER)
/Panel/LED_CH4: U17.9 (QH'), U18.14 (SER)
/Panel/LED_CH5: U18.9 (QH'), U19.14 (SER)
GND: C41.2, C42.2, C43.2, C44.2, C45.2, C46.2, J4.7, J5.7, U14.8 (GND), U15.8 (GND), U16.8 (GND), U17.8 (GND), U18.8 (GND), U19.8 (GND); also elsewhere on the board
unnamed: D7.1 (K), RN1.8 (R1.2)
unnamed: D8.1 (K), RN1.7 (R2.2)
unnamed: D9.1 (K), RN1.6 (R3.2)
unnamed: D10.1 (K), RN1.5 (R4.2)
unnamed: D11.1 (K), RN3.8 (R1.2)
unnamed: D12.1 (K), RN3.7 (R2.2)
unnamed: D13.1 (K), RN3.6 (R3.2)
unnamed: D14.1 (K), RN3.5 (R4.2)
unnamed: D15.1 (K), RN5.8 (R1.2)
unnamed: D16.1 (K), RN5.7 (R2.2)
unnamed: D17.1 (K), RN5.6 (R3.2)
unnamed: D18.1 (K), RN5.5 (R4.2)
unnamed: D19.1 (K), RN7.8 (R1.2)
unnamed: D20.1 (K), RN7.7 (R2.2)
unnamed: D21.1 (K), RN7.6 (R3.2)
unnamed: D22.1 (K), RN7.5 (R4.2)
unnamed: D23.1 (K), RN9.8 (R1.2)
unnamed: D24.1 (K), RN9.7 (R2.2)
unnamed: D25.1 (K), RN9.6 (R3.2)
unnamed: D26.1 (K), RN9.5 (R4.2)
unnamed: D27.1 (K), RN11.8 (R1.2)
unnamed: D28.1 (K), RN11.7 (R2.2)
unnamed: D29.1 (K), RN11.6 (R3.2)
unnamed: D30.1 (K), RN11.5 (R4.2)
unnamed: D31.1 (K), RN2.8 (R1.2)
unnamed: D32.1 (K), RN2.7 (R2.2)
unnamed: D33.1 (K), RN2.6 (R3.2)
unnamed: D34.1 (K), RN2.5 (R4.2)
unnamed: D35.1 (K), RN4.8 (R1.2)
unnamed: D36.1 (K), RN4.7 (R2.2)
unnamed: D37.1 (K), RN4.6 (R3.2)
unnamed: D38.1 (K), RN4.5 (R4.2)
unnamed: D39.1 (K), RN6.8 (R1.2)
unnamed: D40.1 (K), RN6.7 (R2.2)
unnamed: D41.1 (K), RN6.6 (R3.2)
unnamed: D42.1 (K), RN6.5 (R4.2)
unnamed: D43.1 (K), RN8.8 (R1.2)
unnamed: D44.1 (K), RN8.7 (R2.2)
unnamed: D45.1 (K), RN8.6 (R3.2)
unnamed: D46.1 (K), RN8.5 (R4.2)
unnamed: D47.1 (K), RN10.8 (R1.2)
unnamed: D48.1 (K), RN10.7 (R2.2)
unnamed: D49.1 (K), RN10.6 (R3.2)
unnamed: D50.1 (K), RN10.5 (R4.2)
unnamed: D51.1 (K), RN12.8 (R1.2)
unnamed: D52.1 (K), RN12.7 (R2.2)
unnamed: D53.1 (K), RN12.6 (R3.2)
unnamed: D54.1 (K), RN12.5 (R4.2)
unnamed: RN1.1 (R1.1), U14.15 (QA)
unnamed: RN1.2 (R2.1), U14.1 (QB)
unnamed: RN1.3 (R3.1), U14.2 (QC)
unnamed: RN1.4 (R4.1), U14.3 (QD)
unnamed: RN2.1 (R1.1), U14.4 (QE)
unnamed: RN2.2 (R2.1), U14.5 (QF)
unnamed: RN2.3 (R3.1), U14.6 (QG)
unnamed: RN2.4 (R4.1), U14.7 (QH)
unnamed: RN3.1 (R1.1), U15.15 (QA)
unnamed: RN3.2 (R2.1), U15.1 (QB)
unnamed: RN3.3 (R3.1), U15.2 (QC)
unnamed: RN3.4 (R4.1), U15.3 (QD)
unnamed: RN4.1 (R1.1), U15.4 (QE)
unnamed: RN4.2 (R2.1), U15.5 (QF)
unnamed: RN4.3 (R3.1), U15.6 (QG)
unnamed: RN4.4 (R4.1), U15.7 (QH)
unnamed: RN5.1 (R1.1), U16.15 (QA)
unnamed: RN5.2 (R2.1), U16.1 (QB)
unnamed: RN5.3 (R3.1), U16.2 (QC)
unnamed: RN5.4 (R4.1), U16.3 (QD)
unnamed: RN6.1 (R1.1), U16.4 (QE)
unnamed: RN6.2 (R2.1), U16.5 (QF)
unnamed: RN6.3 (R3.1), U16.6 (QG)
unnamed: RN6.4 (R4.1), U16.7 (QH)
unnamed: RN7.1 (R1.1), U17.15 (QA)
unnamed: RN7.2 (R2.1), U17.1 (QB)
unnamed: RN7.3 (R3.1), U17.2 (QC)
unnamed: RN7.4 (R4.1), U17.3 (QD)
unnamed: RN8.1 (R1.1), U17.4 (QE)
unnamed: RN8.2 (R2.1), U17.5 (QF)
unnamed: RN8.3 (R3.1), U17.6 (QG)
unnamed: RN8.4 (R4.1), U17.7 (QH)
unnamed: RN9.1 (R1.1), U18.15 (QA)
unnamed: RN9.2 (R2.1), U18.1 (QB)
unnamed: RN9.3 (R3.1), U18.2 (QC)
unnamed: RN9.4 (R4.1), U18.3 (QD)
unnamed: RN10.1 (R1.1), U18.4 (QE)
unnamed: RN10.2 (R2.1), U18.5 (QF)
unnamed: RN10.3 (R3.1), U18.6 (QG)
unnamed: RN10.4 (R4.1), U18.7 (QH)
unnamed: RN11.1 (R1.1), U19.15 (QA)
unnamed: RN11.2 (R2.1), U19.1 (QB)
unnamed: RN11.3 (R3.1), U19.2 (QC)
unnamed: RN11.4 (R4.1), U19.3 (QD)
unnamed: RN12.1 (R1.1), U19.4 (QE)
unnamed: RN12.2 (R2.1), U19.5 (QF)
unnamed: RN12.3 (R3.1), U19.6 (QG)
unnamed: RN12.4 (R4.1), U19.7 (QH)
VLED: D7.2 (A), D8.2 (A), D9.2 (A), D10.2 (A), D11.2 (A), D12.2 (A), D13.2 (A), D14.2 (A), D15.2 (A), D16.2 (A), D17.2 (A), D18.2 (A), D19.2 (A), D20.2 (A), D21.2 (A), D22.2 (A), D23.2 (A), D24.2 (A), D25.2 (A), D26.2 (A), D27.2 (A), D28.2 (A), D29.2 (A), D30.2 (A), D31.2 (A), D32.2 (A), D33.2 (A), D34.2 (A), D35.2 (A), D36.2 (A), D37.2 (A), D38.2 (A), D39.2 (A), D40.2 (A), D41.2 (A), D42.2 (A), D43.2 (A), D44.2 (A), D45.2 (A), D46.2 (A), D47.2 (A), D48.2 (A), D49.2 (A), D50.2 (A), D51.2 (A), D52.2 (A), D53.2 (A), D54.2 (A), J4.2, J5.2; also elsewhere on the board

Notes on the sheet:
columns 0-3 (lamps 0-3, 24-27)
0 F0 THRU
1 F1 LF
2 F2 160/80
3 F3 60-30
24 0
25 1
26 OK
27 ERR
columns 4-7 (lamps 4-7, 28-31)
4 F4 20-10
5 F5 6/4m
6 F6 2m/AIR
7 F7 70/23cm
28 SYNC
29 CHK
30 GAP
31 RUNT
columns 8-11 (lamps 8-11, 32-35)
8 FR0 SYNC
9 FR1 SYNC
10 FR2 SYNC
11 FR3 B2
32 TMO
33 LNA
34 BYP
35 AUTO
columns 12-15 (lamps 12-15, 36-39)
12 FR4 B1
13 FR5 B0
14 FR6 LNA
15 FR7 QUIET
36 FMN
37 I-LO
38 I-OK
39 I-HI
columns 16-19 (lamps 16-19, 40-43)
16 FR8 CLR
17 FR9 CHK
18 FR10 CHK
19 FR11 CHK
40 TRIP
41 RUN
42 HOLD
43 LOW
columns 20-23 (lamps 20-23, 44-47)
20 FR12 CHK
21 FR13 CHK
22 FR14 CHK
23 RX
44 QUIET
45 DROP
46 GLT
47 RST
OE_N pull-up
Snap-off lamp strip link
Lamp n: row n/24, column n%24; register (n%24)/4 (U14 first), output (n%4) + 4*(n/24) - hal_panel.
Q low = lamp on (sink). 1 mA per lamp: (VLED - 2 V - 0.1 V) / 2k2. Use 2 V LEDs only.
Lamp test lights all 48 (48 mA) with the LNA still off. Outside it, at most 23 lamps.
Panel modes (config frame, kept in flash): full / bands = F0-F7 only / off = OE_N high.
U14-U19, RN1-RN12, D7-D54, C41-C46 and J5 sit on the snap-off strip; J4 on the main board.

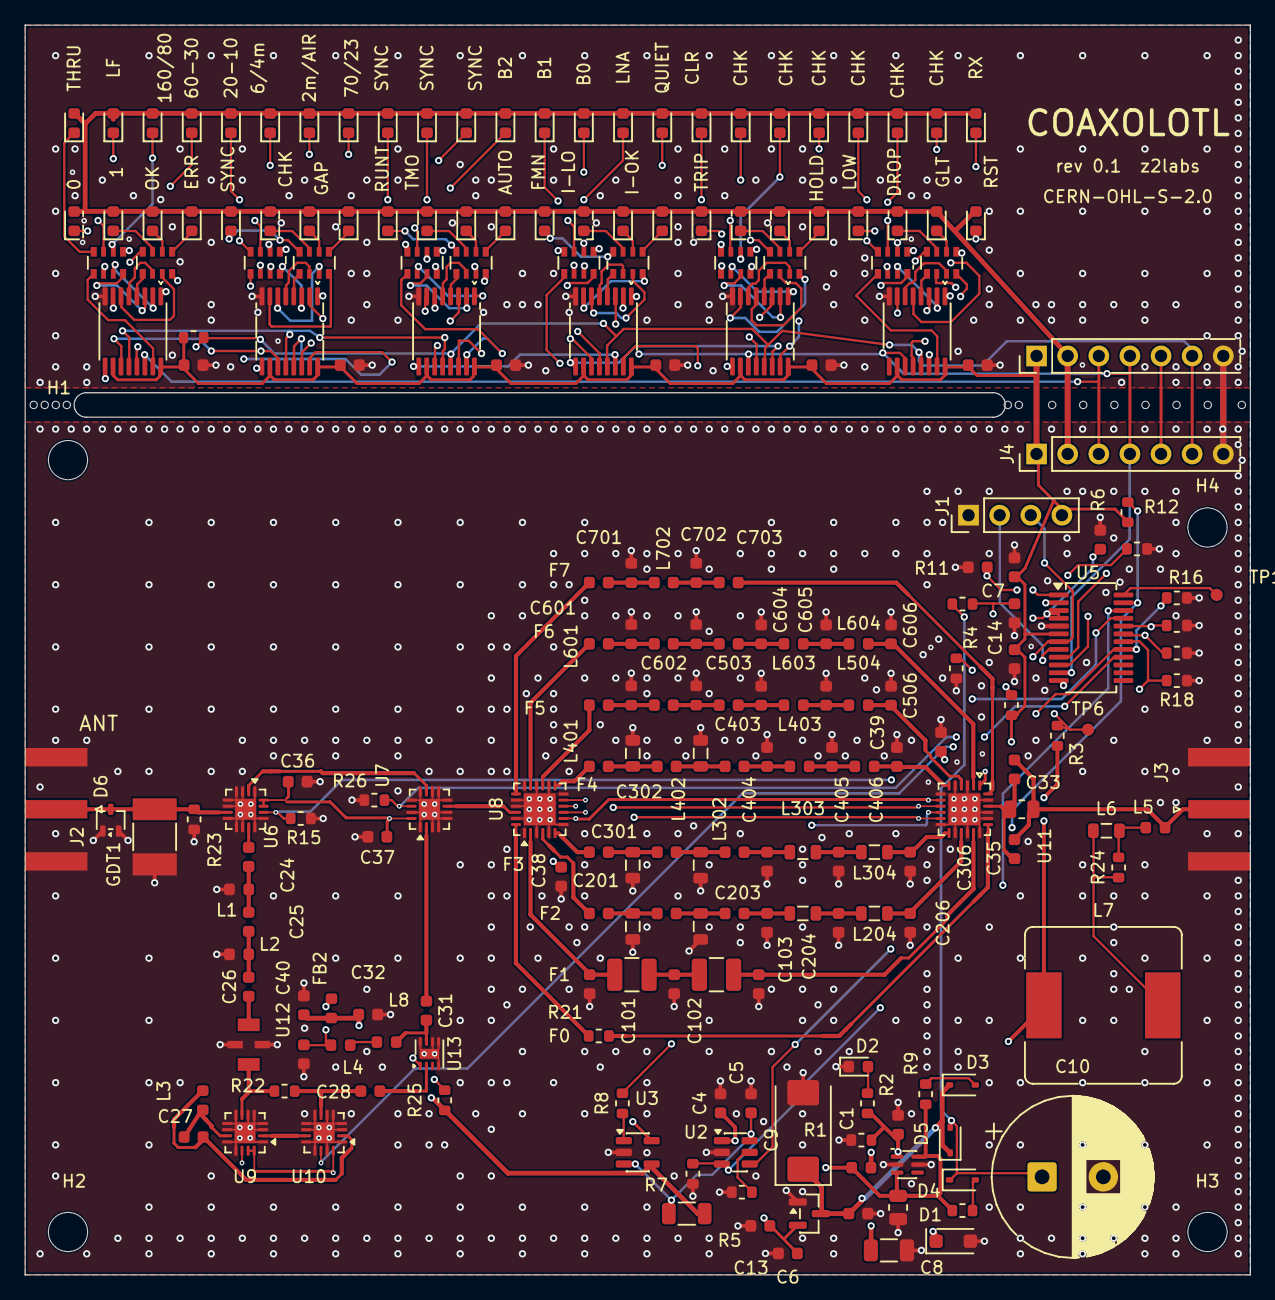
[picture p29: board coaxolotl.kicad_pcb from above]

Board: 4 copper layers, 100.0 x 102.0 mm, 243 parts (0 on the bottom side), 194 nets.

Other parts of the board:
H1, H2, H3, H4: MountingHole_3.2mm_M3
MB1, MB2, MB3, MB4, MB5, MB6, MB7, MB8, MB9, MB10, MB11, MB12, MB13: MouseBite_NPTH_0.6mm
