z2labs/coaxolotl/(commit log)

2026-10-26 Coaxolotl v0.1: bias-T OOK keyed LNA + 8-way filter bank with blinkenlights panel
    - gap-width OOK protocol with sync-calibrated threshold (docs/protocol.md)
    - EFM8BB2 firmware: decoder, app, 48-lamp static panel, Snooze build + SNOOZE=0 bring-up build
    - host keyer (pyrtlsdr / rtl_biast / dry-run) and edge-replay simulator
    - hardware architecture, power budget, pin map, BOM, bring-up checklist
    Claude-Session: https://claude.ai/code/session_01YRUiF8Vp4242sya9Xyg3TV
    [bom.csv]
2026-10-26 Schematic v0.1: power + MCU sheets (KiCad, generated)
    - hardware/kicad/tools/build.py generates root, power, mcu sheets and project symbols
    - check.py: netlist vs intent, undriven power, single-pin nets (KiCad 7 CLI has no ERC)
    - LM66100 CE tied to VOUT (reverse blocking); TPS2553 ILIM noted as VERIFY
    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
    [coaxolotl.kicad_sch, mcu.kicad_sch, power.kicad_sch]
2026-10-26 WIP: zone/place fields, lamp chain moved to P2.0-P2.3, power sheet re-flow
    Pin sides follow placement (QSOP pins 1-12 power/panel side, 13-24 RF side).
    Block diagram and restyle still pending.
    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
    [coaxolotl.kicad_sch, mcu.kicad_sch, power.kicad_sch]
2026-10-26 Schematic v0.2: Redraw with block diagram
    - power/ground only as power symbols (project rails VCOAX, VMAIN, VHOLD, VLED, LNA_VCC)
    - wires inside blocks, hierarchical labels + sheet pins between sheets (no global labels)
    - Value carries critical parameters, blue design-intent notes, bold italic block titles
    - sheet 1: block diagram + wired hierarchy; RF/Panel placeholders with reset-safe pulls
    - pull-downs moved to the receiving parts (TPS2553 EN, RF switches), RC filters to the ADC pins
    - check.py compares net partitions (catches shorts and splits), generator flags 4-way junctions
    - net classes in .kicad_pro (POWER 0.4 mm <= 1.25 x SC-70 pad)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
    [coaxolotl.kicad_sch, mcu.kicad_sch, panel.kicad_sch, power.kicad_sch, rf.kicad_sch]
2026-10-26 Schematic: RF front end and filter bank sheets
    - Sheet 4 RF front end: antenna protection (GDT, BAV99, 100k bleed),
    PE42522 LNA/bypass SPDT pair, 5th-order 25 MHz HPF + LTCC 2.2 GHz LPF,
    FM notch population option (DNP), LNA with bias through RFOUT.
    - Sheet 5 filter bank: 2x PE42582 SP8T, F0 THRU + F1-F7 placeholders,
    broadband bias-T, coax connector, SW_V pull-downs.
    - PE42522 replaces PE42520 (pinout could not be verified).
    - Generator: mirrored symbols, stacked pins; root hierarchy for 6 sheets.
    - gen_bandplan.py maps RF port index to the PE42582 V3V2V1 code.
    - tools/bom.py: grouped BOM generated from the schematic.
    Claude-Ses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
    [bom.csv, coaxolotl.kicad_sch, filterbank.kicad_sch, mcu.kicad_sch, panel.kicad_sch, power.kicad_sch, rf.kicad_sch, rf_frontend.kicad_sch]
2026-10-26 Schematic: QPL9547 LNA, Arial font
    - U13 is the Qorvo QPL9547 (DFN-8 2x2): VDD through the RF_OUT choke,
    R25 sets the bias at VBIAS, R26 holds SHDN low (VERIFY items).
    - All schematic text uses the Arial TrueType face.
    - Docs and generator comments updated.
    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
    [bom.csv, coaxolotl.kicad_sch, filterbank.kicad_sch, mcu.kicad_sch, panel.kicad_sch, power.kicad_sch, rf_frontend.kicad_sch]
2026-10-27 LNA stage follows the SWL434 Spacewalker LNA
    QPL9547: VBIAS via 3k32 + 100 pF, VDD into RF_OUT via 560 nH, 100 pF,
    ferrite bead, 100 pF; SHDN and NC 4/5/8 to GND. DC blocks 1 nF C0G for
    the 25 MHz lower edge.
    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
    [bom.csv, coaxolotl.kicad_sch, filterbank.kicad_sch, mcu.kicad_sch, panel.kicad_sch, power.kicad_sch, rf_frontend.kicad_sch]
2026-10-27 Schematic: panel sheet with 48 lamps
    6x 74HC595 (U14-U19) sinking 48 lamps (D7-D54) from VLED through 2k2 x4
    arrays (RN1-RN12); chain via QH' local labels; OE_N pull-up. Lamp order
    matches firmware/src/panel.h. Custom 595 symbol puts ~SRCLR on top so it
    ties to +3V3 without crossings. check.py no longer has pending nets.
    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
    [bom.csv, coaxolotl.kicad_sch, filterbank.kicad_sch, mcu.kicad_sch, panel.kicad_sch, power.kicad_sch, rf_frontend.kicad_sch]
2026-10-27 Panel modes: full / bands / off via a config frame
    - New config frame: sync 0 1 0, payload PM1 PM0 + 4 reserved bits, same
    inverse check. The decoder tells it from the state frame (1 0 1) with
    the same 1.5x ratio test; old hosts keep working.
    - full = all 48 lamps, bands = F0..F7 only, off = all dark (OE_N high),
    PWR lamp stays. Outside full nothing blinks, so the MCU sleeps more.
    - The mode is logged in flash (page 0x3C00, one byte per change) and
    restored at power-up; the lamp test follows it. Code limit 0x3C00.
    - Host: `coaxolotl.py panel full|bands|off` and ConfigFrame.
    - 29 new firmware checks (179 total), host end-to-end tests.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
    [coaxolotl.kicad_sch, filterbank.kicad_sch, mcu.kicad_sch, panel.kicad_sch, power.kicad_sch, rf_frontend.kicad_sch]
2026-10-27 Schematic: real F1-F7 LC filters, snap-off lamp strip link
    - tools/filters.py: 5th-order Chebyshev 0.1 dB ladders, 50 ohm, E12;
    BPF = HPF + LPF; prints the rounded-value response. F5 is now 30-80 MHz
    (12 dB at 98 MHz instead of 1 dB), bandplan.json updated.
    - Filter bank sheet redrawn around the ladders (C1xx..C7xx, L1xx..L7xx).
    - Panel sheet: J4/J5 unpopulated 1x7 rows at the right end of the break
    line, so a snapped-off lamp strip can be re-linked with a cable.
    - BOM regenerated (224 parts).
    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
    [bom.csv, coaxolotl.kicad_sch, filterbank.kicad_sch, mcu.kicad_sch, panel.kicad_sch, power.kicad_sch, rf_frontend.kicad_sch]
2026-10-27 Schematic: PE42520 SPDTs instead of PE42522
    PE42520C-Z (QFN-16 3x3, LCSC C500478) pinout and truth table checked
    against the LCSC datasheet: LS tied to VDD so CTRL = 0 selects RF1
    (bypass) and the firmware stays unchanged. KiCad library footprint
    QFN-16-1EP_3x3mm_P0.5mm_EP1.7x1.7mm.
    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
    [bom.csv, coaxolotl.kicad_sch, filterbank.kicad_sch, mcu.kicad_sch, panel.kicad_sch, power.kicad_sch, rf_frontend.kicad_sch]
2026-10-27 QPL9547: datasheet footprint (DFN-8 2x2, EP 0.8x1.6), LCSC C5367093
    Datasheet rev D checked: pads 1 VBIAS, 2 RF in, 6 shutdown (low/ground =
    on), 7 RF out + VDD, 3/4/5/8 NC (grounded as on the SWL434), paddle GND;
    R4 3k32 sets IDD = 65 mA, same as R25. KiCad library footprint
    DFN-8-1EP_2x2mm_P0.5mm_EP0.8x1.6mm matches the land pattern.
    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
    [bom.csv, coaxolotl.kicad_sch, filterbank.kicad_sch, mcu.kicad_sch, panel.kicad_sch, power.kicad_sch, rf_frontend.kicad_sch]
2026-10-27 LNA bias feed: 18 nH at RF_OUT (QPL9547 EVB) + 560 nH (SWL434)
    The 560 nH 0603 choke is past its self-resonance above ~400 MHz; an
    18 nH choke at the pin covers the GHz range, the 560 nH the low band.
    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
    [bom.csv, coaxolotl.kicad_sch, filterbank.kicad_sch, mcu.kicad_sch, panel.kicad_sch, power.kicad_sch, rf_frontend.kicad_sch]
2026-10-27 Project footprints: GDT 1812 (SANTE 4532-090V, C476204), FV1206 LTCC filter
    Pads from the LCSC/EasyEDA footprints so JLC's own placement fits.
    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
    [bom.csv, coaxolotl.kicad_sch, filterbank.kicad_sch, mcu.kicad_sch, panel.kicad_sch, power.kicad_sch, rf_frontend.kicad_sch]
2026-10-27 U7/U10 with LS = GND (RF ports swapped) so the LNA/bypass ring is planar
    Two identical SPDTs facing each other need one path to cross on a single
    layer. With LS tied to GND on the output switch (and on the notch output)
    CTRL = 0 selects RF2, so bypass goes RF1 -> RF2 and the LNA path RF2 ->
    RF1: no crossing, no firmware change. Symbol variant PE42520R.
    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
    [coaxolotl.kicad_sch, filterbank.kicad_sch, mcu.kicad_sch, panel.kicad_sch, power.kicad_sch, rf_frontend.kicad_sch]
2026-10-27 U11 with LS = 1: mirror-port pairing makes the filter bank planar
    PE42582 truth table: LS = 1 selects port 9 - port(LS = 0) for the same
    V code, so U8 RF(k+1) pairs with U11 RF(8-k) and the 8 branches run
    between the two facing switches on F.Cu without crossings. Same V lines,
    firmware unchanged; at reset (V = 000) U8 RF1 / U11 RF8 = F0 THRU.
    Symbol variant PE42582R (ports listed RF8..RF1, LS on top).
    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
    [coaxolotl.kicad_sch, filterbank.kicad_sch, mcu.kicad_sch, panel.kicad_sch, power.kicad_sch, rf_frontend.kicad_sch]
2026-10-27 U7 on its own GPIO (P1.4 LNA_PATH_OUT)
    The output SPDT gets its own control line (same polarity, 10k pull-down),
    so the two switches can also be set independently later (e.g. LNA in
    circuit on one side only for tests). Firmware drives both together;
    179/179 host checks pass.
    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
    [bom.csv, coaxolotl.kicad_sch, filterbank.kicad_sch, mcu.kicad_sch, panel.kicad_sch, power.kicad_sch, rf_frontend.kicad_sch]
2026-10-27 PCB build script: outline with snap-off lamp strip, 4-layer stack-up, chain/anchor placement, GND vias, zones
    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
    [pcb_build.py]
2026-10-27 Routing script (3 srouter passes: RF on F.Cu only, power, rest); placement tweaks
    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
2026-10-27 route: RF routed at pin width, widened to 50 ohm afterwards; RF kept out of the later passes
    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
2026-10-27 placement: FM-notch switches at both ends of the R22 link, wider LNA loop; routing: strip pass
    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
2026-10-27 Lamp strip: each register drives the 4 columns above it (both rows), local wiring
    Lamp n sits in row n/24, column n%24; register k drives columns 4k..4k+3 (QA-QD row 1, QE-QH row 2).
    Schematic, netlist, hal_panel() shift order and docs/panel.md follow. Firmware tests 179/179.
    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
    [coaxolotl.kicad_sch, filterbank.kicad_sch, mcu.kicad_sch, panel.kicad_sch, power.kicad_sch, rf_frontend.kicad_sch]
2026-10-27 strip: array orientation by its LED-side pins
    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
2026-10-27 pcb_build keeps the schematic's net classes (pcbnew Save rewrote them); strip bus nets in the strip pass
    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
2026-10-27 escape via for U11 pin 1 (LS = VDD) between the RF risers
    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
2026-10-27 jlc/lcsc_parts.csv: draft part table (codes checked on jlcpcb.com / lcsc.com pages, open items in notes)
    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
    [lcsc_parts.csv]
2026-10-27 fan-out vias for the RF switch control/supply pins (staggered 0.4/0.2 mm)
    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
2026-10-27 fan-out via sites reserved before the spiral placer; min via 0.4 mm
    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
2026-10-27 route: refuse to run without the RF/POWER net classes
    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
2026-10-27 gitignore: KiCad local project settings
    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
2026-10-27 pre-routed chain links and strip tab links; repair pass for connections smoothing dropped; SMA edge DRC rule; one via per LS tie; mouse-bite hole gap
    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
2026-10-27 footprints carry the symbol fields (schematic parity)
    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
2026-10-27 MCU fan-out ring for its passives; repair pass uses the netlist's escaped net names
    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
2026-10-27 route: cleanup (merge near same-net vias, drop dangling vias/stubs) and a --repair mode run after the tidy; DRC rules: SMA edge by memberOfFootprint, 0.075 mm annular; tab hole clear of the GND link;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
2026-10-27 route cleanup edits the board text by uuid (pcbnew Remove+Save unsafe on KiCad 10)
    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
2026-10-27 J2 1 um inside the edge (pads exactly on the edge fail the 0 mm rule)
    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
    [pcb_build.py]
2026-10-27 Routed board: placement, 4 srouter passes, post-route pipeline
    DRC (kicad-cli, schematic parity): 0 errors, 0 unconnected, 0 parity;
    warnings: footprint/library mismatch from silk_dfm (expected), 8 silk.
    Generated by tools/pcb_build.py, tools/route.py, tools/postroute.ps1.
    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
    [coaxolotl.kicad_pcb, coaxolotl_placed.kicad_pcb]
2026-10-27 L6: 10 uH 1210 wire-wound, 450 mA (LQH32CN100K33L, C86069) - it carries the whole coax DC
    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
    [bom.csv, coaxolotl.kicad_sch, filterbank.kicad_sch, lcsc_parts.csv, mcu.kicad_sch, panel.kicad_sch, power.kicad_sch, rf_frontend.kicad_sch]
2026-10-27 simu: filter bank circuit simulation from the netlist (scikit-rf), part-model hooks, Monte Carlo
    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
2026-10-27 simu: datasheet part models (Q, SRF, DCR, C0G Q) for every filter part, stand-ins for the unchosen 0805 inductors and 820 pF; first run with Monte Carlo
    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
2026-10-27 simu/openems: lane N-port job for office-z170 (a port on every part pad, switch pins at the lane ends)
    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
2026-10-27 lane_nport: --lane-only (window = the lane, switch risers left to the circuit model)
    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
2026-10-28 simu: --layout co-simulation (parts joined into the openEMS lane N-port at their pads), F6 result
    F6 2m/AIR with the layout: passband IL 0.85-1.12 dB (parts only 0.72-1.05 dB), RL 16.0 dB,
    -3 dB band 92-215 MHz. Above 700 MHz the stopband is limited to about -45...-60 dB by the
    pad-to-pad coupling of the lane.
    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
2026-10-28 simu: --layout takes the switch pins as the lane ends when the N-port has them (THRU without --lane-only)
    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
2026-10-28 simu: openEMS F7 lane 10-port S-parameters (X99, routed board 6cacac4, 10 MHz-2.5 GHz)
    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
2026-10-28 simu: lane_layout_plot.py (any lane), void_pads.py what-if (inner planes cleared under a lane's signal pads)
    F7 with the layout: pad capacitance ~0.85 pF per lane node to In1 pulls RL to 5.8 dB above 1 GHz.
    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
2026-10-28 simu: openEMS THRU lane 4-port (U8/U11 switch pins + R21 pads, X99, 10 MHz-2.5 GHz)
    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
2026-10-28 simu: F7 layout result and retune (12p/6.8p/12p, 10n/10n absorbs the pad capacitance), plots per lane
    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
2026-10-28 lane_nport: Z2_TWIN picks a kicad_sim.py folder ahead of ~/z2/twin (one twin version on every machine)
    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
2026-10-28 simu README: X99 runs so far used an older kicad_sim; F5 split status
    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
2026-10-28 lane_nport: log the kicad_sim version (path, date, md5) and store it in ports.json
    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
2026-10-28 simu: openEMS F5 lane 20-port (kicad_sim 2026-10-21; excitations 1-11 office-z170, 12-20 X99, merged with --collect)
    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
2026-10-28 simu: F5 with the layout (IL +0.45 dB worst case, RL 10.4 dB)
    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
2026-10-28 simu: F7 lane re-run with kicad_sim 2026-10-21 (X99 via Z2_TWIN, 1.25 MCells)
    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
2026-10-28 simu: F7 confirmed with kicad_sim 2026-10-21, retune unchanged (12p/6.8p/12p, 10n/10n)
    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
2026-10-28 simu: F7 void what-if re-run with kicad_sim 2026-10-21
    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
2026-10-28 simu: F7 void what-if with kicad_sim 2026-10-21 (still port-reference limited)
    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
2026-10-28 simu: THRU lane re-run with kicad_sim 2026-10-21 (office-z170, Z2_MESH_NETS=ports, 4.98 MCells)
    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
2026-10-28 simu: report.py -> 3-page English PDF of the filter-bank simulations (charts, tables)
    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
